Yin-bo-de/wheel_speed_monitor/hardware/README.md

# 转接底板（硬件 v6：正面插装、外设 5V、A3144 脚序）

轮速监测台的转接底板：原理图 + PCB 布局布线，全部脚本生成。Freenove
ESP32-S3 WROOM CAM 开发板**正面朝上**插在底板的两个 20 针排母上（J1 对右排
IO43 列，J2 对左排 3V3 列），霍尔、舵机、遥控、电源的接线全部从底板的端子上走；
开发板全部 40 针另有 1:1 的扩展排针，将来固件用到新脚不用重新打板。板子
**96 × 98.5mm**（v5 把高度从 122 压到 98.5，落进嘉立创 100×100 的打样档；
宽度没动），双层，三个 M2.5 安装孔（v6 取消左下角，给 J12 端子下移让位）。v6 在 v5 基础上改了几件事：开发板改为
正面插装、舵机固定吃板载 5V、霍尔接口脚序改成 A3144 的 +V/GND/OUT；遥控三通道
合并成一个 3 针信号排针，接收机的电源/地仍走 J17；C4 升到 1000µF/16V。

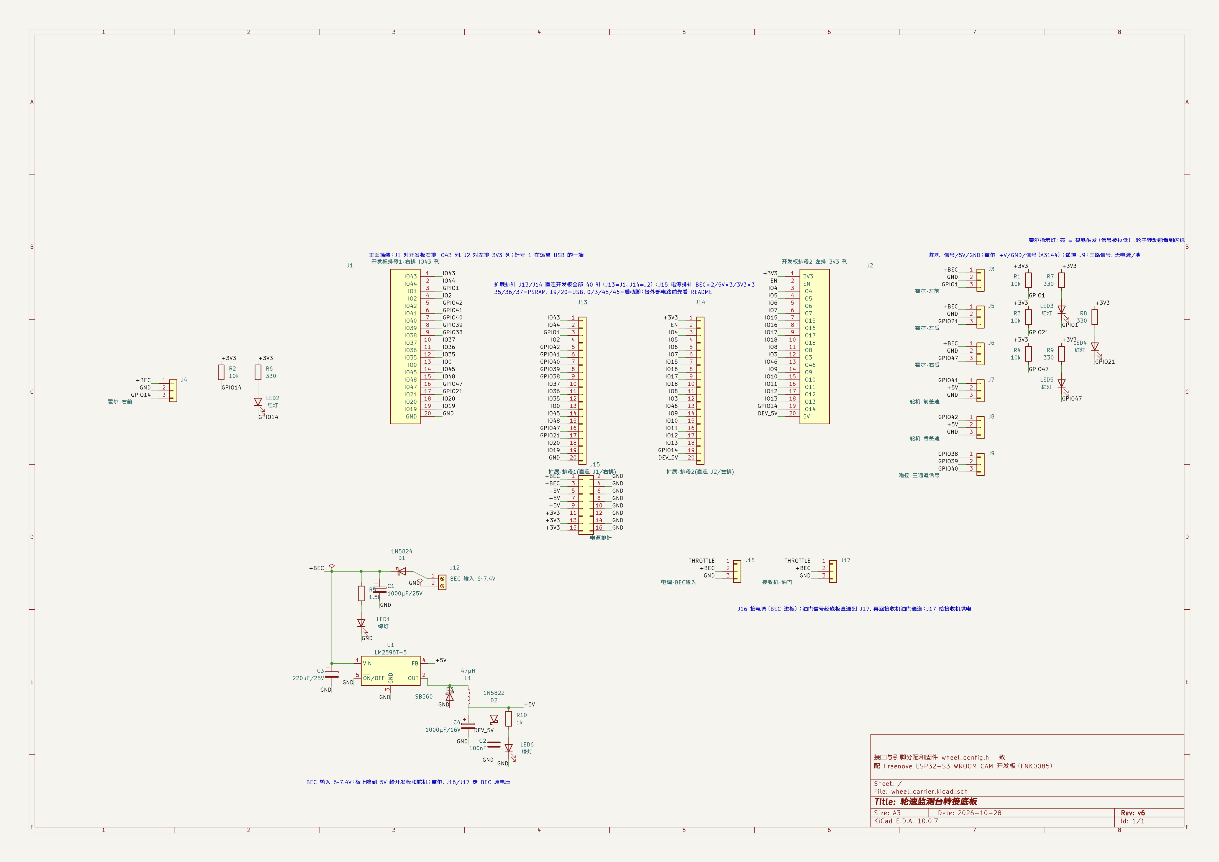
[picture p1: hardware/wheel_carrier/preview.png]
原理图预览


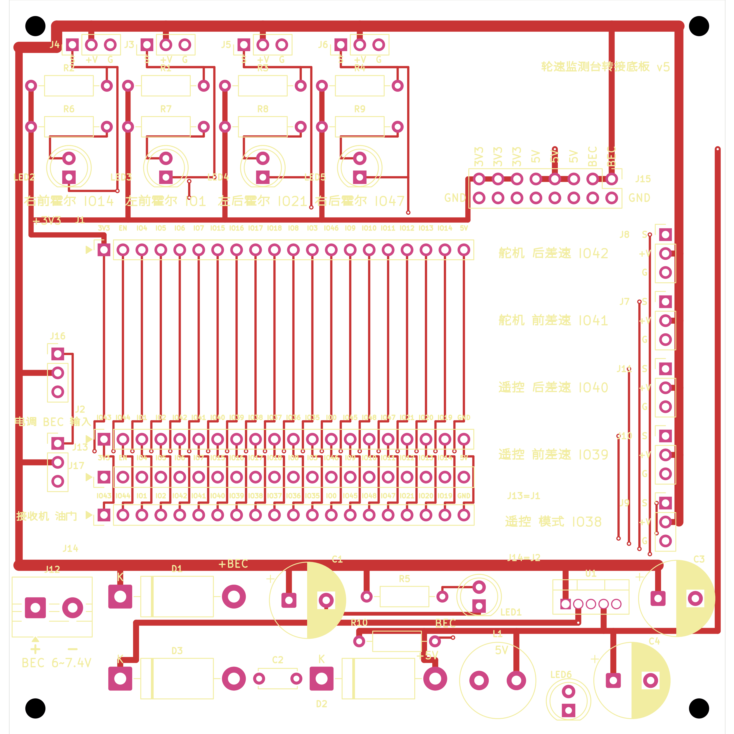
[picture p2: hardware/wheel_carrier/pcb_top.png]
PCB 顶层


- **图纸**：用 KiCad 打开 `wheel_carrier/wheel_carrier.kicad_pro`（双击即可）。
- **生成器**：`scripts/gen_schematic.py`（原理图）+ `scripts/gen_pcb.py`（PCB），
  内容全是脚本里的常量，改完重跑就出新版。
- **验证状态**：原理图 ERC 0/0；PCB DRC **全零**（0 错误、0 警告，含丝印类）；
  Gerber + 钻孔文件已导出（`wheel_carrier/wheel_carrier-gerber.zip`，
  可直接传嘉立创），钻带里含 3 × Ø2.7 安装孔。

## 这块板做什么

| 项目 | 说明 |
|---|---|
| 开发板封装 | 2 个 20 针排母（J1 顶排 = 开发板右排 IO43 列，J2 底排 = 左排 3V3 列），**正面插装** |
| 扩展排针 | **J13/J14 直连开发板全部 40 针（1:1）**；J15 电源条（2×8：BEC×2 / 5V×3 / 3V3×3，其余 8 针全地） |
| 电调 / 油门 | J16 收电调的 3 针插头（BEC 进板）；油门信号经底板直通到 J17 → 接接收机油门通道 |
| 电源输入 | J12 两针螺丝端子进 **BEC 6~7.4V**（电调 BEC 输出） |
| +BEC 主路 | 防反接后分给：J3~J6 霍尔的 +V、J17、J15 的 BEC 针、C1 大电容、降压段 |
| 5V 降压 | LM2596T-5.0 + 47µH 电感 + 续流管 + 输入/输出电容，5V 供开发板和两路舵机 |
| 防倒灌 | D2 串在给开发板的支路上，USB 与底板供电互不倒灌 |
| 霍尔 ×4 | J3 左前 / J4 右前 / J5 左后 / J6 右后，脚序 **+V / GND / 信号**（对 A3144），各配 10k 上拉到 3.3V |
| 霍尔指示 | 每路信号一个 330R + 红灯：**亮 = 磁铁触发**（信号被拉低），转起来能看到闪烁 |
| 舵机 ×2 | J7 前差速 / J8 后差速，+V 固定为板载 **5V** |
| 遥控 | J9 一个 3 针排针：1=模式 / 2=前差速 / 3=后差速，**只走信号**；接收机电源/地走 J17 |
| 大电容 | C1 1000µF/25V 兜输入母线；C4 1000µF/16V 兜 5V 舵机堵转 |
| 指示灯 | LED1 绿灯 = +BEC 已上电；LED6 绿灯 = 降压段有 5V 输出 |

接口脚序不再统一：**舵机 J7/J8 是 信号 / +5V / GND；霍尔 J3~J6 是 +V(BEC) / GND /
信号（A3144 的 1=VCC、2=GND、3=OUT）；遥控 J9 只有三路信号，没有电源和地。**
信号脚的 GPIO 分配与固件 `main/wheel_config.h` 完全一致，软件一行不用改。

### 引脚映射（与固件 wheel_config.h 一致）

| 接口 | 接到开发板排针 | GPIO |
|---|---|---|
| 霍尔·左前 J3 | J1 第 3 针 | 1 |
| 霍尔·右前 J4 | J2 第 19 针 | 14 |
| 霍尔·左后 J5 | J1 第 17 针 | 21 |
| 霍尔·右后 J6 | J1 第 16 针 | 47 |
| 舵机·前差速 J7 | J1 第 6 针 | 41 |
| 舵机·后差速 J8 | J1 第 5 针 | 42 |
| 遥控 J9·1 模式 | J1 第 9 针 | 38 |
| 遥控 J9·2 前差速 | J1 第 8 针 | 39 |
| 遥控 J9·3 后差速 | J1 第 7 针 | 40 |
| 开发板 5V 输入 | J2 第 20 针 | — |
| 开发板 3.3V（上拉与指示取电） | J2 第 1 针 | — |
| 开发板 GND | J1 第 20 针 | — |

排针针号 1 从**远离 USB 口**的一端数起，四个 20 针排针的 1 脚都在最左端
（丝印上有实心三角标），每一针的网名（3V3 / IO4 / IO47…）都印在排针旁边，
装板前对一遍即可。**v6 是正面插装：J1 顶排对应开发板右排（IO43 列），J2 底排
对应左排（3V3 列）**；开发板天线朝左、USB 朝右，和 v5 反面插时的物理朝向一致。
J13/J14 的针号与 J1/J2 一一对应（J13 第 n 针 = J1 第 n 针，J14 = J2），排针右端
另有 J13=J1、J14=J2 标注。

### 扩展排针的用法与红线

将来固件要用新 GPIO（比如二期 IMU 的 I2C），把杜邦线插到 J13/J14 对应针上就行。
引出的脚跟排母是 1:1 并联的，接外设等于并联一支，原功能不受影响。但有几条红线：

| 引脚 | 情况 |
|---|---|
| 35 / 36 / 37 | PSRAM 数据线，接任何外部电路都会把 PSRAM 弄坏（能拿表测，不能接东西） |
| 19 / 20 | 原生 USB 的 D-/D+。用 USB 口烧录/调试时不能接；改走 CH343 口烧录才可复用 |
| 0 / 3 / 45 / 46 | 启动模式脚：上电瞬间被采样，外部电路拉着它们会进不了正常启动 |
| 4–18 | 摄像头位（IO4/IO5 是 I2C）。要复用先拔摄像头排线 |
| 43 / 44 | 板载 CH343 串口，占着烧录通道，别动 |

### 电源条（J15）与电调口（J16/J17）

- **J15 是 2×8 电源条**：上排 8 针是电源（西→东：3V3、3V3、3V3、5V、5V、5V、BEC、BEC），
  下排 8 针全是对应的 GND——每一列「电源 + 地」相邻，两针的杜邦壳插一列就能给传感器
  供电，GND 管够（每个传感器、每根探针都要一根地）。
- **J16 收电调的 3 针插头**：BEC 电压从这里进板（三针插头中间那根必是 +V，
  插反只会信号线和地线换位，电源接不反），油门信号也从这里进板。
- **J17 去接收机**：用三针杜邦线接到接收机的油门通道。板载直通走线把 J16/J17 的
  信号针连通——油门信号「过板」，但那根直通是纯铜走线，**板子不通电也照传信号**，
  主控不在线不会断油门；J17 的 +V 是接收机唯一的电源入口（v6 的 J9 只走信号，
  不再给接收机供电）。
- **遥控 J9**：一个 3 针信号排针，1=模式、2=前差速、3=后差速；接收机的电源和地
  仍从 J17 取，接线时 J17 必须插上，否则三路信号没有参考地。
- 进电方式二选一（或都用）：J12 螺丝端子（粗线 / 大电流）或 J16（即插即用）。
  **同一时间只允许一个电源来源**——别把两路不同电源同时接进这两种入口。

## 设计决定的理由

**电源条为什么是 2×8、每列配一根地。** 一根 2.54 针只插得下一根杜邦线——原版
4 针的电源口挂两个传感器就不够分。传感器真正费的是针位（每台都要电源+地两根），
所以 v4 把电源口扩成 2×8：8 路电源、8 根地按列配对。信号类的预留继续走 J13/J14
扩展排针——不给每个设想都做专用口，真到接线烦了再加。

**电调口（J16/J17）为什么让油门过板。** 电调的三针插头直接插板子，BEC 从口上进
（与 J12 同一个节点，粗线大电流仍旧可以走端子）；油门信号用板上直通走线送到 J17
再回接收机。代价是油门路径多了两个插头，换来的是接线只有两根（电调到板、板到
接收机），而且以后固件想读油门（油门 + 四轮速算滑移率）信号点就在板上，加一根
跳线到空闲 GPIO 即可。v6 把 J9 收成纯信号排针后，J17 还是接收机唯一的电源/地
入口——这一口既送油门信号，也送 BEC 和地。

**为什么把 40 针全部引出来。** 固件还在长（二期有 IMU），下一个功能用哪根脚
说不准；把没在用的脚也引到扩展排针，将来插线即用、不用重新打板。这也是为什么
画在布局之前——原理图阶段加两排针几乎零成本。2.54 杜邦级够接传感器/模块；
真到要大功率或专用连接器的扩展（电机驱动之类），那还是得动板子。

**BEC 的 6/7.4V 不能直接进开发板，也不能直接进舵机。** 开发板 5V 脚是按 5V
设计的，7.4V 灌进去会烧板上的 5V 器件、还会倒灌 USB；普通舵机也只到 6V 左右。
所以板上用 **LM2596T-5.0** 做了一路真降压：TO-220 直插好焊、嘉立创几块钱，配
47µH 电感、续流管、输入（C3 220µF/25V）输出（C4 1000µF/16V）电容，就是这款
芯片的教科书接法。v6 把两路舵机也挂到这路 5V 上，C4 因此从 220µF 加到 1000µF，
堵转时电压更稳。

**舵机吃 5V，接收机吃 J17 的 BEC，霍尔吃 BEC。** 舵机固定 5V 是为了不挑 BEC
档位：6V、7.4V 甚至 4S 直接进板，舵机看到的都是 5V。接收机仍走 J17 的 +BEC，
所以 4S 直接进板时 J17 的 +V 是 16.8V，接收机的 +V 线必须手动空出来（由电调
BEC 单独供电）；J9 只走三路信号，没有电源脚，不受影响。霍尔 A3144 标称
4.5~24V，16.8V 也在范围内，可以继续从 J3~J6 的 +V 取电。

**6V 档时 5V 段会略低于 5.0V，属正常。** BEC 6V 经防反接二极管掉到约 5.6V，
LM2596 在这个压差下接近直通、输出大约 4.9~5.1V。这没有关系：开发板的 3.3V
稳压器输入 4.5V 以上就正常工作，舵机在 4.9V 也能用。7.4V 档时稳压在 5.0V。

**霍尔供电走 BEC、信号上拉走 3.3V。** 之前 3.3V 供电的隐患（A3144 规格下限
4.5V）彻底解决；上拉电压 3.3V 决定 GPIO 高电平，开集电极输出对 ESP32 安全。

**霍尔指示灯的接法与门道。** 每路信号从 3.3V 经 330R 串一个 LED 到信号脚：
信号被传感器拉低（磁铁靠近）时电流导通、灯亮；信号为高时 LED 两端等电位、自动
熄灭。电流约 4mA，在 A3144 的 20mA 灌电流能力之内，也不会把信号拉到读不出低电平。
用 3.3V 而不是 BEC 是刻意的：LED 只借用信号线当"回路"，不往信号里引入 BEC 电压。

**开发板供电串了第二只肖特基 D2。** 插着 USB 调程序时，5V 段和 USB 5V 会在开发
板上顶牛（互相倒灌）。串上之后两边都能单独供电，谁先谁后都无所谓。

**电源网络用标签、不摆电源符号。** 电源符号和同名标签混用会触发 ERC 的
same_local_global_label 警告（本来就是同一张网），统一用标签表达。PWR_FLAG 是
例外——它不改网络名，只负责让 ERC 认可 +BEC/GND 母线有驱动源（降压芯片的
VIN/GND 是 power_in 引脚，没旗标 ERC 会点名）。

## PCB 设计要点

**布局**（`gen_pcb.py` 的 PLACEMENT 表，坐标为焊盘包围盒中心）：
顶部一排是霍尔接口 + 10k 上拉 + 330R/指示灯三行；中部的两个 20 针排母把开发板
架空；右侧只剩 J8 后差速舵机、J7 前差速舵机、J9 遥控三通道三个三针口，自上而下
排列；扩展排针 J13/J14 放在排母正下方，40 根 1:1 竖线呈「线帘」状；电源区在底部。

**布线**（TRACKS 表，直角折线 + 过孔换层）：
- 正面 F.Cu 走信号 + 电源：+BEC 从左脊上到顶、给四个霍尔 +V 和电源条 BEC 列；
  +5V 的舵机支路加粗到 1.2~1.5（J8/J7 堵转电流），+3V3 0.5~0.8，信号 0.3；
  开发板 40 针到扩展排针的竖线利用排母行列间的 1.27mm 间隙；v5 把 J13/J14
  收到 J2 下方 5.08mm 后，扇形引出改成"半间距错位车道"——J1 列的线走 x−1.27、
  J2 列走 x+1.27（两组按时段借用同一条物理车道），每列一个过孔从 B 层直接
  扎进 J13。
- 背面 B.Cu 是整板 GND 铺铜 + 少量跨板长走线（四条霍尔信号、两条舵机 + 三条
  遥控信号、DEV_5V 东缘通道）；v6 把 GPIO14 的横巷放到 J1 北侧、从左侧半间距
  车道下到 J2.19，其余三路霍尔和五路右侧信号在 J1 北/南两侧的 B 层横巷里
  分开走。GND 焊盘靠铺铜的热焊盘自动连通，被走线围死的少数几处改成实心连接。
  被净空围死、又接不到任何焊盘的铺铜碎块会被 KiCad 当孤岛自动删掉（漂浮铜
  不如不要）；而"某片地铜与主铺铜不通"（DRC 报「未连接项目」）优先查**铺铜的
  `min_thickness`**：KiCad 默认 0.254 填不进密集区的窄缝，会把整张地网分裂成
  好几片互相不通的铜块——调到 0.2 后自动合体，比一根根补缝合线本质得多。
  这块板上最明显的例子是 LED3 附近：GPIO1 的 B 层横巷（北/西）和 GPIO14 的
  B 层横巷（南/东）围出一个口袋，口袋里没有 GND 焊盘，铺铜进不去也接不到地，
  KiCad 就把这块孤立铜删掉了——会看到一块空白，这是正常结果，不是漏铺。
- 每个过孔、每段净空都是对着 DRC 报告逐条磨出来的；`gen_pcb.py` 里那些
  「x=... y=...」的注释坐标不是随意摆的，改动前先跑 DRC。

**丝印标注**（`build_silk()`：132 条文字 + 4 个 1 脚三角标，坐标表就在函数里）：

- 九个接口旁印**功能名 + GPIO 号**（如「左后霍尔 IO21」「舵机 前差速 IO41」），
  霍尔标 +V / G / S（对 A3144），舵机标 S / +V / G，遥控 J9 标「模 / 前 / 后」，
  插线不用查图纸；
- J1/J2 与 J13/J14 **每一针的网名**（3V3 / IO4 / IO47…）错行排在排针旁，
  开发板插装、将来插杜邦线都靠它；J1/J2 旁边另印「正面插入 USB→」；
- J15 电源条每个电源脚把自己的电压竖标在所在列的正上方（3V3×3 / 5V×3 / BEC×2），
  下排两端各标一个 GND——一眼读出「上排电源、下排地、每列一对」；
  J16/J17 印功能名（「电调 BEC 输入」「接收机 油门」）；J12 端子下方有 +/- 极性
  和「BEC 6~7.4V」；三条电源母线标了 +BEC / +3V3 / +5V，两个绿灯标了用途；
  右上角是板名与版本。
- 网名不手写——`io_name()` 从网表取，原理图改了 GPIO 分配，构建会直接报错
  而不是印出过期的号；写完先过 `check_silk()` 的几何自检（逐条文字对 182 个
  焊盘开窗、板边、其他文字做包围盒检查），再过 KiCad DRC 复核。

**DRC 与导出的正确姿势**（顺序敏感）：

```bash
CLI=/Applications/KiCad/KiCad.app/Contents/MacOS/kicad-cli
python3 scripts/gen_pcb.py                        # 重新生成（未填铺铜）
"$CLI" pcb drc --refill-zones --save-board \
    --output /tmp/pcb_drc.rpt wheel_carrier/wheel_carrier.kicad_pcb   # 重填铺铜+存回
"$CLI" pcb export gerbers --output wheel_carrier/gerber/ wheel_carrier/wheel_carrier.kicad_pcb
"$CLI" pcb export drill --output wheel_carrier/gerber/ --format excellon \
    --excellon-units mm wheel_carrier/wheel_carrier.kicad_pcb
```

坑：`pcb drc` 不带 `--refill-zones` 时**不填铺铜**，GND 会报几十条假「未连接」；
带上 `--save-board` 才会把铺铜写回文件（gerber 也才有铜皮）。生成器重跑会清掉
铺铜，导出前记得再走一遍这个流程。

另一个坑：kicad-cli 的部分操作（导出/DRC）会把 `.kicad_pro` 重写成完整版，
顺手把 `lib_footprint_mismatch` 的降级忽略丢掉（二十来条警告复活）。
`gen_pcb.py` 每次运行会自动把这条设置补回（自愈），别手工去跟它较劲。

**已知接受项**（都是丝印/外观级，不影响打样与功能）：
- 全项清零：丝印类（位号挪位 + 文字几何自检）与连接类（见下）都已修复，
  DRC 现在是 0 错误 0 警告；
- 此前那条 `unconnected`（LED1 / 中区地铜与外围断开）的根因找到了：**铺铜的
  `min_thickness` 默认 0.254 在密集区填不进窄缝**，把整张地网悄悄分裂成两片；
  调到 0.2（≥ 设计规则下限 0.2）后整片连通——参数在 `gen_pcb.py` 的铺铜段，
  别改回 0.254；
- `lib_footprint_mismatch` 已在 `.kicad_pro` 里降级忽略（我们有意改了位号
  字号和部分焊盘）；U1 的库盘 1.275×1.8 配 1.1 孔、窄边环宽只剩 0.0875
  （低于板厂常规下限 0.13），按 1.4 等比放大（环 0.15），间距和孔径照库不动。
- 安装孔曾经是"隐形"的：`mounting_hole()` 抄库封装时把 pad 节点跳过了，而
  2.7mm 钻孔就挂在 pad 上——钻带里一把 2.7 的刀都没有，铜还直接压在孔位上
  （左上角 +BEC 主干线从孔心穿过）。修复：保留 pad 节点 + 顶干线第一跨绕孔
  （y=6.35 一跨，孔边铜距 0.75），`check_silk()` 也把四个孔的开窗纳入自检。
  教训：KiCad DRC 只认板文件里真实存在的东西，孔没进文件时它不会替你把关。
- v5 压缩到 96 × 98.5 之后，四条 20 针排针的行距只剩 5.08mm：排针脚名标注从
  两行 0.8 号字改成单行 **0.58 号**，`.kicad_pro` 的文字高度下限跟着放到 0.55
  （生成器每次运行自愈，和 `lib_footprint_mismatch` 一样）。丝印密集区的现实
  折中，板厂工艺无压力（看得清要凑近点）。
- v4 那根「救铺铜孤岛」的 GND 缝合线（J1 上方带子）在 v5 里删了：布局收紧后
  那段空档已经小到铺铜自己会忽略，留着反而是一根悬空端（DRC 会点名）。

## BOM（40 个元件，全部直插，方便手焊）

| 位号 | 元件 | 封装 |
|---|---|---|
| J1, J2 | 1×20 排母 | PinSocket_1x20_P2.54mm_Vertical |
| J13, J14 | 1×20 排针（扩展） | PinHeader_1x20_P2.54mm_Vertical |
| J15 | 2×8 排针（电源条） | PinHeader_2x08_P2.54mm_Vertical |
| J3–J9, J16, J17 | 1×3 排针 ×9 | PinHeader_1x03_P2.54mm_Vertical |
| J12 | 2 位 5.0mm 螺丝端子 | MX126-5.0-02P（或同类 bornier） |
| U1 | LM2596T-5.0（固定 5V 降压） | TO-220-5_Vertical |
| L1 | 47µH 直插电感 | L_Radial_D10.0mm（Fastron 07P 或同类） |
| D1 | 1N5824 肖特基（5A，整板总电流含 5V 舵机支路） | D_DO-201AD |
| D2, D3 | D2：1N5822（3A）；D3：SB560（5A/60V，续流管） | D_DO-201AD |
| C1 | 1000µF/25V 电解 | CP_Radial_D10.0mm_P5.00mm |
| C3 | 220µF/25V 电解 | CP_Radial_D10.0mm_P5.00mm |
| C4 | 1000µF/16V 电解（v6 从 220µF 升级） | CP_Radial_D10.0mm_P5.00mm |
| C2 | 100nF 瓷片 | C_Disc_D5.0mm |
| R1–R4 | 10k（霍尔上拉） | R_Axial_DIN0207（P10.16mm） |
| R5, R10 | 1.5k / 1k（电源指示限流；R5 为 BEC、R10 为 5V） | 同上 |
| R6–R9 | 330R（霍尔指示限流） | 同上 |
| LED1, LED6 | 5mm 绿色（BEC / 5V 指示） | LED_D5.0mm |
| LED2–LED5 | 5mm 红色（霍尔指示） | LED_D5.0mm |

> v6 删掉了 J10/J11，遥控三通道并成 J9 一个 3 针信号排针；C4 升到 1000µF/16V。
> C1/R5/D3 已按 4S 输入升级（C1 25V、R5 1.5k、D3 SB560）。4S 接法与注意事项见
> [使用说明书](使用说明书.md)。

## 改图纸的姿势

两条路，选一条：

1. **改常量重跑**（推荐，图纸进 git、每版可复现）：
   ```bash
   python3 scripts/gen_schematic.py          # 原理图：.kicad_sch / .kicad_sym / 工程文件
   python3 scripts/gen_pcb.py                # PCB：.kicad_pcb（导 gerber 前记得重填铺铜，见上）
   python3 scripts/reload_kicad.py           # 让 KiCad 里打开着的图纸立刻刷新（见下）
   ```
   布局常量、网络、元件表都在脚本顶部一节一节排好。
   刷新脚本走 KiCad 的 IPC API（「设置 → 插件」里启用后重启一次 KiCad 生效），
   等价于菜单 File → Revert：PCB 能直接刷新；原理图侧 KiCad 10 的 API 还没实现，
   得在 eeschema 里手动按 File → Revert（一步，也不用关软件）。Revert 会丢弃
   界面上未保存的手工改动，和菜单行为一致。
2. **直接在 KiCad 里改**：改完必须同步回脚本，否则下次重跑会被覆盖。同步走
   `kicad-sync` 技能（对话里输 `/kicad-sync`；工具在
   `~/.claude/skills/kicad-sync/scripts/`，是仓外的东西，换机器要带走）：
   `board_diff.py --vs-generated` 语义对比找出改动（KiCad 每次保存都会重排
   格式，逐字节 diff 读不了）→ 改动翻译进脚本 → `rebuild.py` 重跑生成器、
   闭环核对（差异必须归零）、重出全部产物。

自检三件套（改完跑一遍）：

```bash
CLI=/Applications/KiCad/KiCad.app/Contents/MacOS/kicad-cli
"$CLI" sch erc --severity-all --output /tmp/erc.rpt wheel_carrier/wheel_carrier.kicad_sch
"$CLI" sch export netlist --format kicadsexpr --output /tmp/wheel.net wheel_carrier/wheel_carrier.kicad_sch
"$CLI" sch export pdf --output /tmp/sch.pdf wheel_carrier/wheel_carrier.kicad_sch
# PDF 转图目检：sips -s format png -Z 4400 /tmp/sch.pdf --out /tmp/sch.png
```

几条给后来人的提醒（全是实际踩过的坑）：

- 旋转 90° 摆放的器件，属性文字要写 90° 角度（相对符号）才会横排；而且 KiCad
  会把 180° 的文字翻正显示、同时反转左右对齐——旋转件文字用「居中」定位最省心。
- 密集区里，相邻器件的伸线端点如果落在同一坐标，两条网络会被静默短接（ERC 都
  不一定报）。上拉电阻那排就是这么撞过一回，改成了标签直贴引脚端点。生成器里的
  `g()` 会断言所有坐标在 1.27 网格上，但「同坐标」这类问题还是要靠网表核对。
- KiCad 官方库里不少器件是 `extends` 派生写法（比如 LM2596T-5 继承 LM2596T-12
  的图形）。`kicad_lib.resolve_symbol()` 会自动把父符号的图形/引脚并进来，直接
  用 `find_symbol` 会拿到没有引脚的空壳。
- **PCB 封装的原点在 1 号焊盘上，不是器件中心**：直接按「中心」摆位整体会偏
  半个身位——配好的脚位全错过、外框互相压（实测一次撞出 20 多处）。`gen_pcb.py`
  的 PLACEMENT 表坐标语义是「焊盘包围盒中心」，由脚本解析封装尺寸自动换算；
  手工加件、手改坐标时记住这个语义。
- **同网络的走线允许自然汇合**：走线冲突不一定要绕开，经常可以「把两段的同网
  成员接在一起」（比如霍尔信号直接汇进它在扩展排针的绕行竖线上）。这块板靠
  这一手把四条霍尔网和五条遥控/舵机网从「单层必打结」里救了出来；而冲突点
  不用肉眼找，DRC 报告会给精确到 0.01mm 的坐标。
- **丝印文字压到焊盘开窗会被阻焊裁掉**（字缺一块，不可接受）、压到器件自带
  丝印框只是外观告警。所以 `gen_pcb.py` 内置 `check_silk()`：每条文字对全部
  焊盘开窗、板边、其他文字做包围盒检查，不通过直接构建失败——比生成后再看
  DRC 报告改得快。注意校验用的是保守字宽（CJK 按 1.15 倍字号估），改字号后
  留的空档别贴着估出来的边。
- **旋转 270° 的器件改位号位置时，局部坐标的 x 在屏幕上是 y 方向**：R10 挪
  位号时改错了分量，字往下方跑了一格。`REF_MOVES` 表里的坐标都是各封装自己
  的局部系，改之前先把 `rot_off()` 的换算方向默写一遍。
- **位号默认位置是封装库给的**，好几个默认就压邻件（LED1/LED6 的位号压在
  R5/R10 焊盘上会被阻焊裁断、C4 的位号压在 C3 的丝印圆上）。这类问题不用等
  DRC：`check_silk()` 会把位号也当文字检查（`ref_local()` 保证自检读到的位置
  就是文件里写的位置），`REF_MOVES` 表收集所有需要挪的位号。

## 本版明确没做的事

- 保险丝、霍尔信号滤波电容（当前用不上，避免多焊点）
- 打样下单与回板焊接（下一步；gerber 已就绪）
- 传感器/接收机侧的线束加工（沿用现有线材即可）
- 舵机没有独立 5V BEC：两路舵机和开发板共用板上 LM2596，3A 是芯片上限；
  换大舵机时要么另配 5V BEC，要么重新评估这一路
- 接收机电源/地只走 J17，J9 不单独供电；接线时 J17 必须插上，否则三路信号
  没有参考地
- 转向通道输入口、I2C（MPU6050）专用口：从 J13/J14 扩展排针拉杜邦就能用
  （任何空闲 GPIO 都在上面），真到接线嫌烦时再加一轮
