Yin-bo-de/wheel_speed_monitor/hardware/wheel_carrier/pcb_bot.png

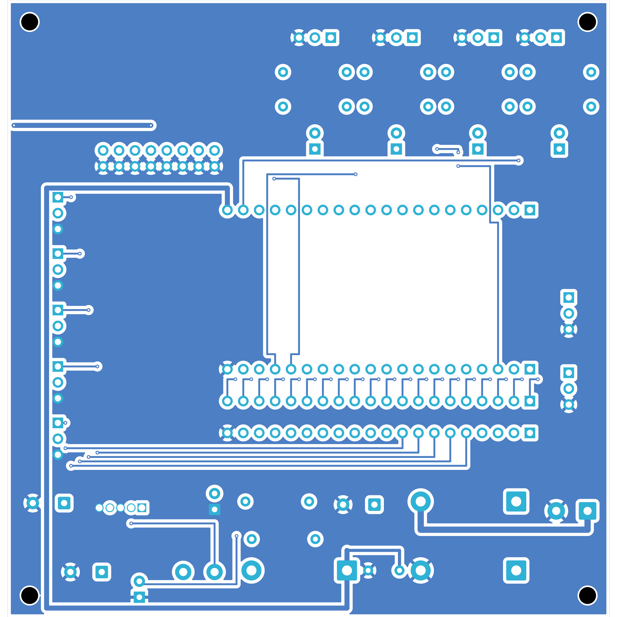
hardware/wheel_carrier/pcb_bot.png
