Yin-bo-de/wheel_speed_monitor/hardware/wheel_carrier/wheel_carrier.kicad_pcb

## KiCad design hardware/wheel_carrier/wheel_carrier.kicad_pcb (2026-10-30)

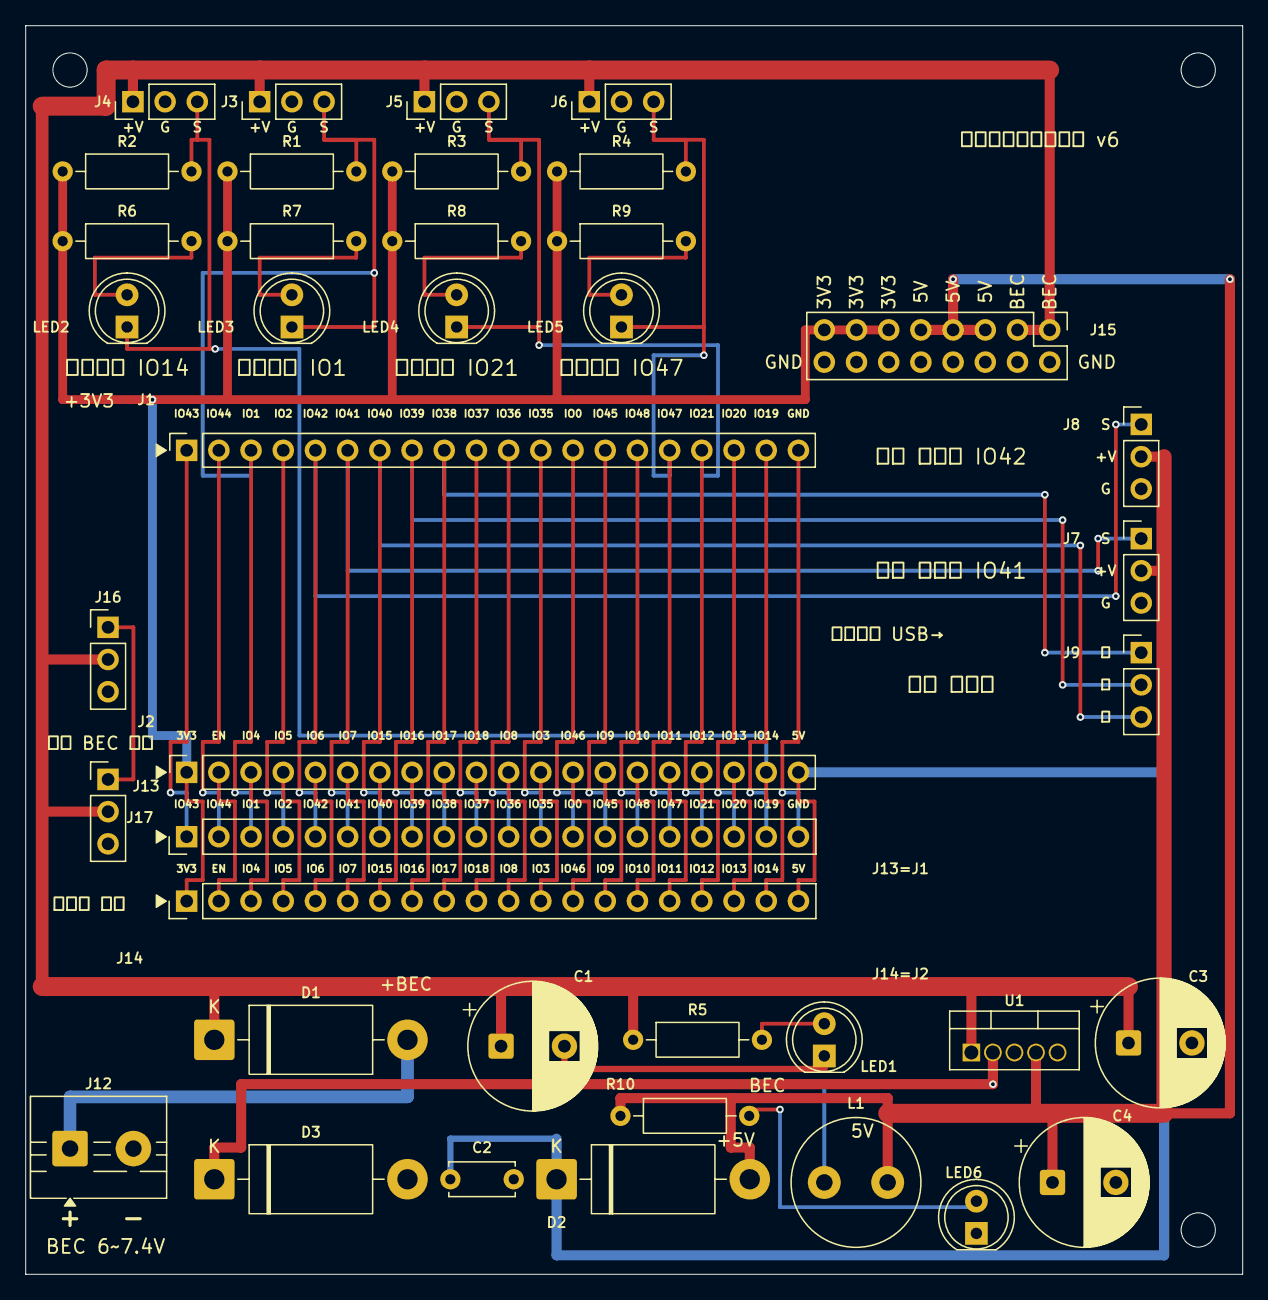
[picture p4: board wheel_carrier.kicad_pcb from above]

Board: 2 copper layers, 96.0 x 98.5 mm, 40 parts (0 on the bottom side), 51 nets.

Parts:
C1: 1000µF/25V; CP_Radial_D10.0mm_P5.00mm
C2: 100nF; C_Disc_D5.0mm_W2.5mm_P5.00mm
C3: 220µF/25V; CP_Radial_D10.0mm_P5.00mm
C4: 1000µF/16V; CP_Radial_D10.0mm_P5.00mm
D1: 1N5824; D_DO-201AD_P15.24mm_Horizontal
D2: 1N5822; D_DO-201AD_P15.24mm_Horizontal
D3: SB560; D_DO-201AD_P15.24mm_Horizontal
J1: 开发板排母1·右排(IO43列); PinSocket_1x20_P2.54mm_Vertical
J2: 开发板排母2·左排(3V3列); PinSocket_1x20_P2.54mm_Vertical
J3: 霍尔·左前; PinHeader_1x03_P2.54mm_Vertical
J4: 霍尔·右前; PinHeader_1x03_P2.54mm_Vertical
J5: 霍尔·左后; PinHeader_1x03_P2.54mm_Vertical
J6: 霍尔·右后; PinHeader_1x03_P2.54mm_Vertical
J7: 舵机·前差速; PinHeader_1x03_P2.54mm_Vertical
J8: 舵机·后差速; PinHeader_1x03_P2.54mm_Vertical
J9: 遥控·三通道信号; PinHeader_1x03_P2.54mm_Vertical
J12: BEC 输入 6~7.4V; TerminalBlock_MaiXu_MX126-5.0-02P_1x02_P5.00mm
J13: 扩展·排母1(直连 J1/右排); PinHeader_1x20_P2.54mm_Vertical
J14: 扩展·排母2(直连 J2/左排); PinHeader_1x20_P2.54mm_Vertical
J15: 电源排针; PinHeader_2x08_P2.54mm_Vertical
J16: 电调·BEC输入; PinHeader_1x03_P2.54mm_Vertical
J17: 接收机·油门; PinHeader_1x03_P2.54mm_Vertical
L1: 47µH; L_Radial_D10.0mm_P5.00mm_Fastron_07P
LED1, LED6: 绿灯; LED_D5.0mm
LED2, LED3, LED4, LED5: 红灯; LED_D5.0mm
R1, R2, R3, R4: 10k; R_Axial_DIN0207_L6.3mm_D2.5mm_P10.16mm_Horizontal
R5: 1.5k; R_Axial_DIN0207_L6.3mm_D2.5mm_P10.16mm_Horizontal
R6, R7, R8, R9: 330; R_Axial_DIN0207_L6.3mm_D2.5mm_P10.16mm_Horizontal
R10: 1k; R_Axial_DIN0207_L6.3mm_D2.5mm_P10.16mm_Horizontal
U1: LM2596T-5; TO-220-5_Vertical

Connections:
+3V3: J2.1, J14.1, J15.11, J15.13, J15.15, R1.1, R2.1, R3.1, R4.1, R6.1, R7.1, R8.1, R9.1
+5V: C4.1, D2.2, J7.2, J8.2, J15.5, J15.7, J15.9, L1.2, R10.1, U1.4
+BEC: C1.1, C3.1, D1.1, J3.1, J4.1, J5.1, J6.1, J15.1, J15.3, J16.2, J17.2, R5.1, U1.1
DEV_5V: C2.1, D2.1, J2.20, J14.20
EN: J2.2, J14.2
GND: C1.2, C2.2, C3.2, C4.2, D3.2, J1.20, J3.2, J4.2, J5.2, J6.2, J7.3, J8.3, J12.2, J13.20, J15.2, J15.4, J15.6, J15.8, J15.10, J15.12, J15.14, J15.16, J16.3, J17.3, LED1.1, LED6.1, U1.3, U1.5
GPIO1: J1.3, J3.3, J13.3, LED3.1, R1.2
GPIO14: J2.19, J4.3, J14.19, LED2.1, R2.2
GPIO21: J1.17, J5.3, J13.17, LED4.1, R3.2
GPIO38: J1.9, J9.1, J13.9
GPIO39: J1.8, J9.2, J13.8
GPIO40: J1.7, J9.3, J13.7
GPIO41: J1.6, J7.1, J13.6
GPIO42: J1.5, J8.1, J13.5
GPIO47: J1.16, J6.3, J13.16, LED5.1, R4.2
IO0: J1.13, J13.13
IO2: J1.4, J13.4
IO3: J2.12, J14.12
IO4: J2.3, J14.3
IO5: J2.4, J14.4
IO6: J2.5, J14.5
IO7: J2.6, J14.6
IO8: J2.11, J14.11
IO9: J2.14, J14.14
IO10: J2.15, J14.15
IO11: J2.16, J14.16
IO12: J2.17, J14.17
IO13: J2.18, J14.18
IO15: J2.7, J14.7
IO16: J2.8, J14.8
IO17: J2.9, J14.9
IO18: J2.10, J14.10
IO19: J1.19, J13.19
IO20: J1.18, J13.18
IO35: J1.12, J13.12
IO36: J1.11, J13.11
IO37: J1.10, J13.10
IO43: J1.1, J13.1
IO44: J1.2, J13.2
IO45: J1.14, J13.14
IO46: J2.13, J14.13
IO48: J1.15, J13.15
unnamed: D1.2, J12.1
unnamed: D3.1, L1.1, U1.2
unnamed: LED1.2, R5.2
unnamed: LED2.2, R6.2
unnamed: LED3.2, R7.2
unnamed: LED4.2, R8.2
unnamed: LED5.2, R9.2
unnamed: LED6.2, R10.2
THROTTLE: J16.1, J17.1
