Yin-bo-de/wheel_speed_monitor/main/config_params.c

/* config_params 实现：见头文件注释。 */
#include <string.h>

#include "config_params.h"

void cfg_params_default(cfg_params_t *cfg)
{
    memset(cfg, 0, sizeof(*cfg));
    cfg->magnets = 1;
    cfg->wheel_diam_mm = 105;
    cfg->alpha = 0.3f;
    for (int i = 0; i < CFG_WHEEL_COUNT; i++) {
        cfg->wheel_enabled[i] = true;
    }
    cfg->sim_on = false;
    cfg->debounce_ms = 0;

    cfg->servo_sim = true;
    for (int i = 0; i < CFG_SERVO_COUNT; i++) {
        cfg->servo_en[i] = true;
        /* 两档默认取标准角度舵机的对称两端附近：解锁在中位、锁定偏一端。
         * 前后轴给同一组值——谁装反了谁把这两档改到行程另一端，不要替用户猜。 */
        cfg->servo_unlock_us[i] = 1500;
        cfg->servo_lock_us[i] = 2000;
        cfg->servo_manual_us[i] = 1500;
    }
    cfg->servo_mode = CFG_SERVO_MODE_AUTO;

    cfg->slip_engage_ratio = 0.30f;
    cfg->slip_min_rpm = 10.0f;
    /* 3 秒持续确认：单拍毛刺不触发机械锁，满 3 秒才认为真打滑 */
    cfg->slip_confirm_ms = 3000;
    cfg->lock_hold_ms = 3000;
    cfg->lock_hold_max_ms = 30000;
    cfg->probe_window_ms = 2000;
    cfg->servo_sim_speed_us_s = 3000;

    cfg->rc_sim = false;
    /* 模式通道给 1000（自动区）：打开遥控模拟时不该平白把差速锁从自动改成手动，
     * 想让遥控接管就自己把滑杆推过 1500 */
    cfg->rc_sim_us[0] = 1000;
    cfg->rc_sim_us[1] = 1500;
    cfg->rc_sim_us[2] = 1500;

    /* 摄像头默认按需启动：手机连上热点、打开设置页都不采集。验证台一行
     * 预览请求就够启动，保留 always 给调试常开用。 */
    cfg->cam_policy = CFG_CAM_POLICY_ON_DEMAND;
    cfg->cam_res = CFG_CAM_RES_QVGA;
    cfg->cam_quality = 12;
    cfg->cam_fps_cap = 15; /* 采集和发送共用；网络差时服务端会临时下调 */
    cfg->overlay_mask = CFG_CAM_OVERLAY_ALL;
}

/* 脉宽数组（两档与手动目标同量程）：逐元素判边界，前后轴互不牵连——
 * 前轴填错不该让后轴那组正确值一起被拒。刻意不要求 unlock != lock：
 * 两档相同只是让该轴锁定时不动，调试 PWM 链路时正是想要的效果。 */
static bool servo_us_pair_ok(const uint32_t us[CFG_SERVO_COUNT])
{
    for (int i = 0; i < CFG_SERVO_COUNT; i++) {
        if (us[i] < CFG_SERVO_US_MIN || us[i] > CFG_SERVO_US_MAX) {
            return false;
        }
    }
    return true;
}

esp_err_t cfg_params_validate(const cfg_params_t *cfg, const char *field)
{
    if (cfg == NULL || field == NULL) {
        return ESP_ERR_INVALID_ARG;
    }

    if (strcmp(field, "magnets") == 0) {
        if (cfg->magnets < CFG_MAGNETS_MIN || cfg->magnets > CFG_MAGNETS_MAX) {
            return ESP_ERR_INVALID_ARG;
        }
    } else if (strcmp(field, "diam") == 0 || strcmp(field, "diam_mm") == 0) {
        if (cfg->wheel_diam_mm < CFG_DIAM_MM_MIN || cfg->wheel_diam_mm > CFG_DIAM_MM_MAX) {
            return ESP_ERR_INVALID_ARG;
        }
    } else if (strcmp(field, "alpha") == 0) {
        if (cfg->alpha < CFG_ALPHA_MIN || cfg->alpha > CFG_ALPHA_MAX) {
            return ESP_ERR_INVALID_ARG;
        }
    } else if (strcmp(field, "debounce") == 0 || strcmp(field, "debounce_ms") == 0) {
        if (cfg->debounce_ms > 1000) {
            return ESP_ERR_INVALID_ARG; /* 上限 1s（窗口周期 50ms，去抖带宽合理） */
        }
    } else if (strcmp(field, "servo_unlock_us") == 0) {
        if (!servo_us_pair_ok(cfg->servo_unlock_us)) {
            return ESP_ERR_INVALID_ARG;
        }
    } else if (strcmp(field, "servo_lock_us") == 0) {
        if (!servo_us_pair_ok(cfg->servo_lock_us)) {
            return ESP_ERR_INVALID_ARG;
        }
    } else if (strcmp(field, "servo_manual_us") == 0) {
        if (!servo_us_pair_ok(cfg->servo_manual_us)) {
            return ESP_ERR_INVALID_ARG;
        }
    } else if (strcmp(field, "servo_mode") == 0) {
        if (cfg->servo_mode > CFG_SERVO_MODE_AUTO) {
            return ESP_ERR_INVALID_ARG;
        }
    } else if (strcmp(field, "slip_engage_ratio") == 0) {
        if (cfg->slip_engage_ratio < CFG_SLIP_ENGAGE_MIN || cfg->slip_engage_ratio > 1.0f) {
            return ESP_ERR_INVALID_ARG;
        }
    } else if (strcmp(field, "slip_min_rpm") == 0) {
        if (cfg->slip_min_rpm < 0.0f || cfg->slip_min_rpm > CFG_SLIP_MIN_RPM_MAX) {
            return ESP_ERR_INVALID_ARG;
        }
    } else if (strcmp(field, "lock_hold_ms") == 0) {
        if (cfg->lock_hold_ms < CFG_LOCK_HOLD_MIN_MS ||
            cfg->lock_hold_ms > CFG_LOCK_HOLD_MAX_MS) {
            return ESP_ERR_INVALID_ARG;
        }
    } else if (strcmp(field, "lock_hold_max_ms") == 0) {
        if (cfg->lock_hold_max_ms < CFG_LOCK_HOLD_MIN_MS ||
            cfg->lock_hold_max_ms > CFG_LOCK_HOLD_MAX_MS ||
            cfg->lock_hold_max_ms < cfg->lock_hold_ms) {
            return ESP_ERR_INVALID_ARG; /* 上限低于初始 → 翻倍退避失去意义 */
        }
    } else if (strcmp(field, "probe_window_ms") == 0) {
        if (cfg->probe_window_ms < CFG_PROBE_WINDOW_MIN_MS ||
            cfg->probe_window_ms > CFG_PROBE_WINDOW_MAX_MS) {
            return ESP_ERR_INVALID_ARG;
        }
    } else if (strcmp(field, "slip_confirm_ms") == 0) {
        if (cfg->slip_confirm_ms > CFG_SLIP_CONFIRM_MAX_MS) {
            return ESP_ERR_INVALID_ARG; /* 0 合法：立即锁，保留旧行为 */
        }
    } else if (strcmp(field, "servo_sim_speed_us_s") == 0) {
        if (cfg->servo_sim_speed_us_s < CFG_SIM_SPEED_MIN ||
            cfg->servo_sim_speed_us_s > CFG_SIM_SPEED_MAX) {
            return ESP_ERR_INVALID_ARG;
        }
    } else if (strcmp(field, "rc_sim_us") == 0) {
        /* 与舵机脉宽同量程：模拟值最终要不经换算地喂进 rc_input，
         * 那里的量程校验就是这一条，两边保持同一个边界 */
        for (int i = 0; i < CFG_RC_CH_COUNT; i++) {
            if (cfg->rc_sim_us[i] < CFG_SERVO_US_MIN || cfg->rc_sim_us[i] > CFG_SERVO_US_MAX) {
                return ESP_ERR_INVALID_ARG;
            }
        }
    } else if (strcmp(field, "cam_policy") == 0) {
        if (cfg->cam_policy > CFG_CAM_POLICY_ALWAYS) {
            return ESP_ERR_INVALID_ARG;
        }
    } else if (strcmp(field, "cam_res") == 0) {
        if (cfg->cam_res > CFG_CAM_RES_SVGA) {
            return ESP_ERR_INVALID_ARG;
        }
    } else if (strcmp(field, "cam_quality") == 0) {
        if (cfg->cam_quality < CFG_CAM_QUALITY_MIN ||
            cfg->cam_quality > CFG_CAM_QUALITY_MAX) {
            return ESP_ERR_INVALID_ARG;
        }
    } else if (strcmp(field, "cam_fps_cap") == 0) {
        if (cfg->cam_fps_cap < CFG_CAM_FPS_MIN || cfg->cam_fps_cap > CFG_CAM_FPS_MAX) {
            return ESP_ERR_INVALID_ARG;
        }
    } else if (strcmp(field, "overlay_mask") == 0) {
        /* 未知位整条拒绝：前端只认低 4 位，固件多收的位只会造成
         * "勾选项存在但没人画"的静默不一致。 */
        if ((cfg->overlay_mask & ~CFG_CAM_OVERLAY_ALL) != 0) {
            return ESP_ERR_INVALID_ARG;
        }
    }
    /* en/sim/sim_rpm/servo_en 为 bool 数组，JSON 解析层负责类型约束 */
    return ESP_OK;
}

/* ---- v1 段（0..31）：两版共用 ---- */

static void pack_v1_segment(const cfg_params_t *cfg, uint8_t *buf)
{
    buf[0] = CFG_PARAMS_BLOB_VERSION;
    buf[1] = (uint8_t)cfg->magnets;
    memcpy(buf + 2, &cfg->wheel_diam_mm, 4);
    memcpy(buf + 6, &cfg->alpha, 4);
    uint8_t en = 0;
    for (int i = 0; i < CFG_WHEEL_COUNT; i++) {
        if (cfg->wheel_enabled[i]) {
            en |= (uint8_t)(1 << i);
        }
    }
    buf[10] = en;
    buf[11] = cfg->sim_on ? 1 : 0;
    memcpy(buf + 12, cfg->sim_rpm, 16);
    memcpy(buf + 28, &cfg->debounce_ms, 4);
}

static void unpack_v1_segment(const uint8_t *buf, cfg_params_t *out)
{
    out->magnets = buf[1];
    memcpy(&out->wheel_diam_mm, buf + 2, 4);
    memcpy(&out->alpha, buf + 6, 4);
    uint8_t en = buf[10];
    for (int i = 0; i < CFG_WHEEL_COUNT; i++) {
        out->wheel_enabled[i] = (en >> i) & 1;
    }
    out->sim_on = buf[11] != 0;
    memcpy(out->sim_rpm, buf + 12, 16);
    memcpy(&out->debounce_ms, buf + 28, 4);
}

/* ---- v3 段（32..75）：舵机与锁定策略 ----
 * v3 比 v2 长 4 字节：脉宽从 min/center/max 三个共享值（6B）
 * 变成每通道两档（8B），后面每个字段的偏移都跟着挪 2 字节。 */

static void pack_v3_segment(const cfg_params_t *cfg, uint8_t *buf)
{
    uint16_t unlock[CFG_SERVO_COUNT];
    uint16_t lock[CFG_SERVO_COUNT];
    uint16_t manual[CFG_SERVO_COUNT];
    uint8_t en = 0;
    for (int i = 0; i < CFG_SERVO_COUNT; i++) {
        unlock[i] = (uint16_t)cfg->servo_unlock_us[i];
        lock[i] = (uint16_t)cfg->servo_lock_us[i];
        manual[i] = (uint16_t)cfg->servo_manual_us[i];
        if (cfg->servo_en[i]) {
            en |= (uint8_t)(1 << i);
        }
    }

    /* buf[34] 只留低 4 位的模式：v2 曾把 invert 位图塞在高 4 位，
     * v3 起高 4 位恒 0（脉宽本身就表达方向，不再需要反向开关） */
    buf[32] = cfg->servo_sim ? 1 : 0;
    buf[33] = en;
    buf[34] = (uint8_t)(cfg->servo_mode & 0x0F);
    memcpy(buf + 35, unlock, 4);
    memcpy(buf + 39, lock, 4);
    memcpy(buf + 43, manual, 4);
    memcpy(buf + 47, &cfg->slip_engage_ratio, 4);
    memcpy(buf + 51, &cfg->slip_min_rpm, 4);
    memcpy(buf + 55, &cfg->lock_hold_ms, 4);
    memcpy(buf + 59, &cfg->lock_hold_max_ms, 4);
    memcpy(buf + 63, &cfg->probe_window_ms, 4);
    memcpy(buf + 67, &cfg->servo_sim_speed_us_s, 4);
    /* 71..75 保留 */
}

static void unpack_v3_segment(const uint8_t *buf, cfg_params_t *out)
{
    uint16_t unlock[CFG_SERVO_COUNT] = {0};
    uint16_t lock[CFG_SERVO_COUNT] = {0};
    uint16_t manual[CFG_SERVO_COUNT] = {0};

    out->servo_sim = buf[32] != 0;
    uint8_t en = buf[33];
    for (int i = 0; i < CFG_SERVO_COUNT; i++) {
        out->servo_en[i] = (en >> i) & 1;
    }
    out->servo_mode = buf[34] & 0x0F;
    memcpy(unlock, buf + 35, 4);
    memcpy(lock, buf + 39, 4);
    memcpy(manual, buf + 43, 4);
    for (int i = 0; i < CFG_SERVO_COUNT; i++) {
        out->servo_unlock_us[i] = unlock[i];
        out->servo_lock_us[i] = lock[i];
        out->servo_manual_us[i] = manual[i];
    }
    memcpy(&out->slip_engage_ratio, buf + 47, 4);
    memcpy(&out->slip_min_rpm, buf + 51, 4);
    memcpy(&out->lock_hold_ms, buf + 55, 4);
    memcpy(&out->lock_hold_max_ms, buf + 59, 4);
    memcpy(&out->probe_window_ms, buf + 63, 4);
    memcpy(&out->servo_sim_speed_us_s, buf + 67, 4);
}

/* v2 → v3 迁移：旧布局只有一组共享的 min/center/max + invert，新布局是
 * 每通道两个落点。旧语义里"解锁 = 中位，锁定 = 偏向 invert 决定的那一端"
 * （即旧映射下 +90° 对应的那一端），照此换算后行为逐位等价，
 * 用户升级不需要重新标定。
 * 偏移刻意照抄 v2 当年的位置写死，不跟 v3 共用——两版从 buf[41] 起就错开了。 */
static void unpack_v2_segment(const uint8_t *buf, cfg_params_t *out)
{
    uint16_t min_us = 0, center_us = 0, max_us = 0;
    uint16_t manual[CFG_SERVO_COUNT] = {0};

    out->servo_sim = buf[32] != 0;
    uint8_t en = buf[33];
    uint8_t inv = (uint8_t)((buf[34] >> 4) & 0x0F);
    for (int i = 0; i < CFG_SERVO_COUNT; i++) {
        out->servo_en[i] = (en >> i) & 1;
    }
    out->servo_mode = buf[34] & 0x0F;
    memcpy(&min_us, buf + 35, 2);
    memcpy(&center_us, buf + 37, 2);
    memcpy(&max_us, buf + 39, 2);
    memcpy(manual, buf + 41, 4);
    for (int i = 0; i < CFG_SERVO_COUNT; i++) {
        out->servo_unlock_us[i] = center_us;
        out->servo_lock_us[i] = ((inv >> i) & 1) ? min_us : max_us;
        out->servo_manual_us[i] = manual[i];
    }
    memcpy(&out->slip_engage_ratio, buf + 45, 4);
    memcpy(&out->slip_min_rpm, buf + 49, 4);
    memcpy(&out->lock_hold_ms, buf + 53, 4);
    memcpy(&out->lock_hold_max_ms, buf + 57, 4);
    memcpy(&out->probe_window_ms, buf + 61, 4);
    memcpy(&out->servo_sim_speed_us_s, buf + 65, 4);
}

/* ---- v4 段（76..83）：遥控输入 ----
 * 追加在 v3 段之后，v1/v3 两段的偏移一个字节都不动：旧固件写下的 blob
 * 在新固件里逐字节可解，新固件写下的 blob 交给旧固件也只会被版本号挡住。 */

static void pack_v4_segment(const cfg_params_t *cfg, uint8_t *buf)
{
    uint16_t sim[CFG_RC_CH_COUNT];
    for (int i = 0; i < CFG_RC_CH_COUNT; i++) {
        sim[i] = (uint16_t)cfg->rc_sim_us[i];
    }
    buf[76] = cfg->rc_sim ? 1 : 0;
    memcpy(buf + 77, sim, sizeof(sim));
    /* 83 保留 */
}

static void unpack_v4_segment(const uint8_t *buf, cfg_params_t *out)
{
    uint16_t sim[CFG_RC_CH_COUNT] = {0};

    out->rc_sim = buf[76] != 0;
    memcpy(sim, buf + 77, sizeof(sim));
    for (int i = 0; i < CFG_RC_CH_COUNT; i++) {
        out->rc_sim_us[i] = sim[i];
    }
}

/* ---- v5 段（84..91）：摄像头 ----
 * 四个单字节字段放前面，末 4 字节是叠加位图。这样 v4 的 0..83 一个字节
 * 都不动，旧固件写的 blob 在新固件里照常解出，升级只补默认值。 */

static void pack_v5_segment(const cfg_params_t *cfg, uint8_t *buf)
{
    buf[84] = (uint8_t)cfg->cam_policy;
    buf[85] = (uint8_t)cfg->cam_res;
    buf[86] = (uint8_t)cfg->cam_quality;
    buf[87] = (uint8_t)cfg->cam_fps_cap;
    memcpy(buf + 88, &cfg->overlay_mask, 4);
}

static void unpack_v5_segment(const uint8_t *buf, cfg_params_t *out)
{
    out->cam_policy = buf[84];
    out->cam_res = buf[85];
    out->cam_quality = buf[86];
    out->cam_fps_cap = buf[87];
    memcpy(&out->overlay_mask, buf + 88, 4);
}

/* ---- v6 段（92..95）：打滑确认期 ----
 * 追加在 v5 段之后，旧段偏移一个字节都不动：旧固件写的 blob 照常解出，
 * 只补一个默认确认期，升级后不会退化成"立即锁"。 */

static void pack_v6_segment(const cfg_params_t *cfg, uint8_t *buf)
{
    memcpy(buf + 92, &cfg->slip_confirm_ms, 4);
}

static void unpack_v6_segment(const uint8_t *buf, cfg_params_t *out)
{
    memcpy(&out->slip_confirm_ms, buf + 92, 4);
}

esp_err_t cfg_params_pack(const cfg_params_t *cfg, uint8_t *buf, size_t len)
{
    if (cfg == NULL || buf == NULL || len < CFG_PARAMS_BLOB_SIZE) {
        return ESP_ERR_INVALID_ARG;
    }
    memset(buf, 0, CFG_PARAMS_BLOB_SIZE);
    pack_v1_segment(cfg, buf);
    pack_v3_segment(cfg, buf);
    pack_v4_segment(cfg, buf);
    pack_v5_segment(cfg, buf);
    pack_v6_segment(cfg, buf);
    return ESP_OK;
}

esp_err_t cfg_params_unpack(const uint8_t *buf, size_t len, cfg_params_t *out)
{
    if (buf == NULL || out == NULL || len == 0) {
        return ESP_ERR_INVALID_ARG;
    }

    /* 先铺默认值：旧版 blob 缺什么字段，新参数就必须落到默认值而不是 0，
     * 否则升级后会得到一组非法配置（如脉宽全 0）。 */
    cfg_params_default(out);

    if (buf[0] == CFG_PARAMS_BLOB_VERSION_1) {
        if (len < CFG_PARAMS_BLOB_SIZE_V1) {
            return ESP_ERR_INVALID_ARG;
        }
        unpack_v1_segment(buf, out);
        return ESP_OK; /* 新版字段保持默认；上层随后回写最新版 */
    }
    if (buf[0] == CFG_PARAMS_BLOB_VERSION_2) {
        if (len < CFG_PARAMS_BLOB_SIZE_V2) {
            return ESP_ERR_INVALID_ARG;
        }
        unpack_v1_segment(buf, out);
        unpack_v2_segment(buf, out); /* 旧布局，按旧语义换算成两档 */
        return ESP_OK;
    }
    if (buf[0] == CFG_PARAMS_BLOB_VERSION_3) {
        if (len < CFG_PARAMS_BLOB_SIZE_V3) {
            return ESP_ERR_INVALID_ARG;
        }
        unpack_v1_segment(buf, out);
        unpack_v3_segment(buf, out);
        return ESP_OK; /* 遥控字段保持默认；上层随后回写最新版 */
    }
    if (buf[0] == CFG_PARAMS_BLOB_VERSION_4) {
        if (len < CFG_PARAMS_BLOB_SIZE_V4) {
            return ESP_ERR_INVALID_ARG;
        }
        unpack_v1_segment(buf, out);
        unpack_v3_segment(buf, out);
        unpack_v4_segment(buf, out);
        return ESP_OK; /* 摄像头字段保持默认；上层随后回写 v5 */
    }
    if (buf[0] == CFG_PARAMS_BLOB_VERSION_5) {
        if (len < CFG_PARAMS_BLOB_SIZE_V5) {
            return ESP_ERR_INVALID_ARG;
        }
        unpack_v1_segment(buf, out);
        unpack_v3_segment(buf, out);
        unpack_v4_segment(buf, out);
        unpack_v5_segment(buf, out);
        return ESP_OK; /* 确认期保持默认 3000ms；上层随后回写 v6 */
    }
    if (buf[0] == CFG_PARAMS_BLOB_VERSION) {
        if (len < CFG_PARAMS_BLOB_SIZE) {
            return ESP_ERR_INVALID_ARG;
        }
        unpack_v1_segment(buf, out);
        unpack_v3_segment(buf, out);
        unpack_v4_segment(buf, out);
        unpack_v5_segment(buf, out);
        unpack_v6_segment(buf, out);
        return ESP_OK;
    }
    return ESP_ERR_INVALID_VERSION;
}
