Yin-bo-de/wheel_speed_monitor/main/config_params.h

/*
 * config_params：车载运行参数的纯 C 模型，宿主机可测（无 IDF 依赖）。
 * 配置存储由 main 的 config_store 负责（NVS 薄封装），这里只做：
 * 默认值、逐字段校验、NVS blob 打包/解包。
 *
 * blob 版本迁移：v1（32B）是一期的布局；v2（72B）在尾部追加舵机与锁定策略
 * 参数；v3（76B）把舵机脉宽从"共享的 min/center/max + invert"换成"每通道的
 * 解锁/锁定两档"；v4（84B）在尾部追加遥控输入（模拟开关与三路模拟脉宽）；
 * v5（92B）在尾部追加摄像头策略、分辨率、画质、采集/发送帧率上限与叠加位图；
 * v6（96B）在尾部追加打滑确认期（首次判定打滑后需连续满足多久才上锁）。
 * 解包按首字节版本号分派——旧 blob 仍可解，缺失字段取默认值（v2 还要按旧
 * 语义换算，见 cfg_params_unpack），上层解出后回写最新版，升级不丢用户已设的配置。
 */
#ifndef CONFIG_PARAMS_H
#define CONFIG_PARAMS_H

#include <stdbool.h>
#include <stddef.h>
#include <stdint.h>

#include "esp_err.h"

#ifdef __cplusplus
extern "C" {
#endif

#define CFG_WHEEL_COUNT 4
#define CFG_SERVO_COUNT 2 /* 0=前差速 1=后差速 */
#define CFG_RC_CH_COUNT 3 /* 遥控三路：0=模式 1=前差速 2=后差速（与 rc_input 顺序一致） */

#define CFG_MAGNETS_MIN 1
#define CFG_MAGNETS_MAX 16
#define CFG_DIAM_MM_MIN 10
#define CFG_DIAM_MM_MAX 300
#define CFG_ALPHA_MIN 0.05f
#define CFG_ALPHA_MAX 1.0f

/* 舵机脉宽：标准角度舵机的常见量程，两端各留余量 */
#define CFG_SERVO_US_MIN 500
#define CFG_SERVO_US_MAX 2500

#define CFG_SERVO_MODE_MANUAL 0
#define CFG_SERVO_MODE_AUTO 1

#define CFG_SLIP_ENGAGE_MIN 0.05f
#define CFG_SLIP_MIN_RPM_MAX 2000.0f

#define CFG_LOCK_HOLD_MIN_MS 200
#define CFG_LOCK_HOLD_MAX_MS 60000
#define CFG_PROBE_WINDOW_MIN_MS 200
#define CFG_PROBE_WINDOW_MAX_MS 10000
/* 打滑确认期上限 60s；下限 0 = 立即上锁（保留旧行为） */
#define CFG_SLIP_CONFIRM_MAX_MS 60000
#define CFG_SIM_SPEED_MIN 100
#define CFG_SIM_SPEED_MAX 20000

/* 摄像头策略：off 永不初始化；on_demand 由第一个流/快照请求启动；always 调试常开。 */
#define CFG_CAM_POLICY_OFF 0
#define CFG_CAM_POLICY_ON_DEMAND 1
#define CFG_CAM_POLICY_ALWAYS 2

#define CFG_CAM_RES_QVGA 0
#define CFG_CAM_RES_VGA 1
#define CFG_CAM_RES_SVGA 2

#define CFG_CAM_QUALITY_MIN 4
#define CFG_CAM_QUALITY_MAX 63
#define CFG_CAM_FPS_MIN 5
#define CFG_CAM_FPS_MAX 25

/* 叠加位图：低 4 位有定义，其余位一律拒绝，避免"页面以为开了、固件不认识"。 */
#define CFG_CAM_OVERLAY_WHEELS (1u << 0)
#define CFG_CAM_OVERLAY_SERVO (1u << 1)
#define CFG_CAM_OVERLAY_RC (1u << 2)
#define CFG_CAM_OVERLAY_SYS (1u << 3)
#define CFG_CAM_OVERLAY_ALL (CFG_CAM_OVERLAY_WHEELS | CFG_CAM_OVERLAY_SERVO | \
                             CFG_CAM_OVERLAY_RC | CFG_CAM_OVERLAY_SYS)

/* blob 定长布局（尾部补零）：
 *   v1 段 0..31：版本(1B) + magnets(1B) + diam(4B) + alpha(4B float)
 *               + wheel_enabled(1B 位图) + sim_on(1B) + sim_rpm[4](16B) + debounce_ms(4B)
 *   v3 段 32..75：servo_sim(1B) + servo_en(1B 位图) + servo_mode(1B)
 *               + unlock_us(u16×2) + lock_us(u16×2) + manual_us(u16×2)
 *               + engage/min_rpm(float×2) + lock_hold/max/probe(u32×3)
 *               + sim_speed(u32) + 保留(5B)
 *   v4 段 76..83：rc_sim(1B) + rc_sim_us(u16×3) + 保留(1B)
 *   v5 段 84..91：cam_policy(1B) + cam_res(1B) + cam_quality(1B)
 *               + cam_fps_cap(1B) + overlay_mask(u32)
 *   v6 段 92..95：slip_confirm_ms(u32)
 * v2 段（32..71）与 v3 段是同义不同形：v2 用共享的 min/center/max + invert
 * 位图描述脉宽，v3 换成每通道两档，因此长 4 字节、其余字段偏移整体后移。 */
#define CFG_PARAMS_BLOB_VERSION 6
#define CFG_PARAMS_BLOB_SIZE 96
#define CFG_PARAMS_BLOB_VERSION_1 1
#define CFG_PARAMS_BLOB_SIZE_V1 32
#define CFG_PARAMS_BLOB_VERSION_2 2
#define CFG_PARAMS_BLOB_SIZE_V2 72
#define CFG_PARAMS_BLOB_VERSION_3 3
#define CFG_PARAMS_BLOB_SIZE_V3 76
#define CFG_PARAMS_BLOB_VERSION_4 4
#define CFG_PARAMS_BLOB_SIZE_V4 84
#define CFG_PARAMS_BLOB_VERSION_5 5
#define CFG_PARAMS_BLOB_SIZE_V5 92

typedef struct {
    uint32_t magnets;    /* 每转磁铁数 1-16 */
    uint32_t wheel_diam_mm; /* 轮径（毫米）10-300 */
    float alpha;         /* EMA 系数 0.05-1.0 */
    bool wheel_enabled[CFG_WHEEL_COUNT];
    bool sim_on;         /* 模拟模式总开关 */
    float sim_rpm[CFG_WHEEL_COUNT];
    uint32_t debounce_ms; /* 最小脉冲间隔去抖；0=关闭 */

    /* ---- v2：差速舵机（v3 起脉宽改为每通道两档） ---- */
    bool servo_sim; /* true=模拟舵机模型；false=LEDC 驱动真实舵机 */
    bool servo_en[CFG_SERVO_COUNT];
    /* 自动模式只有这两个落点，前后轴各配一组：差速器的锁止/释放是两个确定的
     * 机械位置，中间行程没有意义。反装的舵机把两档改填到行程另一端即可，
     * 不必再引入一个"反向"开关。 */
    uint32_t servo_unlock_us[CFG_SERVO_COUNT]; /* 解锁档（正常行驶位置） */
    uint32_t servo_lock_us[CFG_SERVO_COUNT];   /* 锁定档（差速锁死位置） */
    uint32_t servo_mode;                       /* CFG_SERVO_MODE_* */
    uint32_t servo_manual_us[CFG_SERVO_COUNT]; /* 手动模式目标脉宽 */

    /* ---- v2：打滑判定与锁定策略 ---- */
    float slip_engage_ratio;   /* 打滑进入门槛 */
    float slip_min_rpm;        /* 低于此转速不判定 */
    uint32_t lock_hold_ms;     /* 初始锁定保持时长（"地形时间"） */
    uint32_t lock_hold_max_ms; /* 保持时长翻倍上限 */
    uint32_t probe_window_ms;  /* 试探窗口：车连续动满此时长才算脱困 */
    uint32_t servo_sim_speed_us_s; /* 模拟舵机行程速率（µs/秒） */

    /* ---- v4：遥控输入 ---- */
    bool rc_sim; /* true=注入模拟遥控信号；false=读 GPIO 上的真实捕获 */
    /* 三路模拟脉宽，顺序同 rc_input：模式 / 前差速 / 后差速。
     * 模式通道默认落在自动区（1000），打开模拟不会平白把模式翻成手动。 */
    uint32_t rc_sim_us[CFG_RC_CH_COUNT];

    /* ---- v5：摄像头 ---- */
    uint32_t cam_policy;    /* CFG_CAM_POLICY_*，默认 on_demand */
    uint32_t cam_res;       /* CFG_CAM_RES_*，默认 QVGA */
    uint32_t cam_quality;   /* JPEG quality 4..63，值小画质高 */
    uint32_t cam_fps_cap;   /* 采集/发送帧率上限 5..25；传感器支持时直接降采集帧率 */
    uint32_t overlay_mask;  /* CFG_CAM_OVERLAY_* 位图 */

    /* ---- v6：打滑确认 ---- */
    uint32_t slip_confirm_ms; /* 首次打滑后需连续满足多久才上锁；0=立即锁 */
} cfg_params_t;

void cfg_params_default(cfg_params_t *cfg);

/* 校验单字段；字段名与 JSON 命令一致（magnets、diam、alpha、en、sim、
 * sim_rpm、debounce，以及 v2 的舵机与锁定策略各字段、v6 的 slip_confirm_ms，
 * 见上表）。
 * 未知字段返回 ESP_OK（命令层忽略）。
 * 跨字段约束（min<center<max、hold_max>=hold）随任一相关字段被写时一并检查，
 * 前端整组提交即保持一致。 */
esp_err_t cfg_params_validate(const cfg_params_t *cfg, const char *field);

/* v1 与 v2 两种长度的 blob 都可解（按首字节版本号分派）。 */
esp_err_t cfg_params_unpack(const uint8_t *buf, size_t len, cfg_params_t *out);

esp_err_t cfg_params_pack(const cfg_params_t *cfg, uint8_t *buf, size_t len);

#ifdef __cplusplus
}
#endif

#endif /* CONFIG_PARAMS_H */
