Yin-bo-de/wheel_speed_monitor/main/bench_cam.c

/* bench_cam 实现：见头文件与 docs/CAMERA_DESIGN.md 4.5.1。 */
#include <string.h>

#include "bench_cam.h"

#include "cam_rate.h"
#include "camera_drv.h"
#include "esp_heap_caps.h"
#include "esp_log.h"
#include "esp_timer.h"
#include "freertos/task.h"

#include "wheel_config.h"

static const char *TAG = "benchcam";

/* 控制器是独立纯 C 组件，帧率边界必须和配置校验保持一致。 */
_Static_assert(CAM_RATE_FPS_MIN == CFG_CAM_FPS_MIN, "cam_rate min fps mismatch");
_Static_assert(CAM_RATE_FPS_MAX == CFG_CAM_FPS_MAX, "cam_rate max fps mismatch");
_Static_assert(CAM_QUALITY_MIN == CFG_CAM_QUALITY_MIN, "quality min mismatch");
_Static_assert(CAM_QUALITY_MAX == CFG_CAM_QUALITY_MAX, "quality max mismatch");

#define CAM_IDLE_POLL_MS 20
#define CAM_PREVIEW_HOLD_MS 30000
#define CAM_STREAM_GRACE_MS 30000
#define CAM_FAIL_LIMIT 3
/* 7 帧只有 0.5 秒，一次抢占就能把基准拉偏；20 帧把偶发抖动摊薄，
 * 仍然是按需预览可接受的启动等待（默认帧率下约 1.3 秒）。 */
#define CAM_FPS_CALIB_FRAMES 20
/* init 后 AEC/AGC 还在收敛，暗环境前几帧曝光时间长，先丢几帧再测。 */
#define CAM_FPS_CALIB_SETTLE_FRAMES 5
/* 限速状态下测不到真实基准：目标低于 base 时传感器被分频拉低。
 * 定期恢复默认时序重测，跟踪光照变化。 */
#define CAM_BASE_RECAL_MS 30000
/* 重测切换寄存器后先丢几帧，等新时序稳定。 */
#define CAM_FPS_RECAL_SETTLE_FRAMES 3
/* 未限速时实际帧率就是基准，和采集日志共用 5 秒窗口观测更新。 */
#define CAM_BASE_OBSERVE_MS 5000
#define CAM_DEADLINE_NONE UINT32_MAX

typedef enum {
    CAM_OFF = 0,
    CAM_IDLE,
    CAM_INIT,
    CAM_ON,
    CAM_FAIL,
} cam_state_t;

typedef enum {
    ACT_NONE = 0,
    ACT_INIT,
    ACT_DEINIT,
    ACT_SET_FPS,
    ACT_GRAB,
} cam_action_t;

static cfg_params_t *s_cfg;
static SemaphoreHandle_t s_cfg_mutex;
static SemaphoreHandle_t s_lock;

/* 以下状态都归 s_lock 保护（相机驱动句柄本身只归 cam_publish_task）。 */
static cam_state_t s_state = CAM_IDLE;
static uint32_t s_applied_policy = CFG_CAM_POLICY_ON_DEMAND;
static uint32_t s_applied_res = CFG_CAM_RES_QVGA;
static uint32_t s_applied_quality = 12; /* 用户配置值 */
/* 自适应画质：帧率到下限仍拥堵时提高 quality 数值（压缩更强、帧更小），
 * 网络恢复后还回用户配置。决策在纯 C 的 cam_quality 里，本文件只负责
 * 把结果写进传感器。 */
static cam_quality_t s_quality;
static bool s_quality_pending; /* 待 cam_publish_task 写入传感器 */
static bool s_quality_auto_ok = true;
static uint32_t s_quality_fail_count;
/* 连续写失败这么多次就停掉自适应画质，避免每轮循环都去打扰 SCCB。 */
#define CAM_QUALITY_FAIL_LIMIT 3
static uint32_t s_cached_overlay = CFG_CAM_OVERLAY_ALL;
static cam_rate_t s_rate;
/* 用户在设置页配的上限。控制器实际用的上限还要和实测 base 取小，
 * 否则目标会抬到传感器达不到的帧率。 */
static uint32_t s_user_fps_cap = CFG_CAM_FPS_MAX;

/* 流任务句柄：发布新帧后直接通知它，发送节奏锁定到传感器出帧。
 * 只由流任务在启动时写一次，指针读写是原子的，不需要加锁。 */
static TaskHandle_t s_frame_wait_task;

static bool s_preview_active;
static bool s_stream_active;
static bool s_stop_stream;
static bool s_init_requested;
static bool s_reinit_requested;
/* OTA 挂起：httpd 任务写，cam_task 每轮在锁内读取。 */
static bool s_ota_suspend;
static uint32_t s_preview_deadline = CAM_DEADLINE_NONE;
static uint32_t s_grace_deadline = CAM_DEADLINE_NONE;

static uint8_t *s_pub;
static size_t s_pub_cap;
static size_t s_frame_len;
static uint32_t s_frame_gen;
static uint32_t s_last_frame_ms;
static float s_fps;
static uint32_t s_fps_window_ms;
static uint32_t s_fps_frames;
/* 采集帧率日志用独立的 5 秒窗口，和 camstream 的发送窗口同口径；
 * s_fps 仍按 1 秒窗口更新，遥测页面要的是及时性。 */
static uint32_t s_fps_log_start_ms;
static uint32_t s_fps_log_frames;
static uint32_t s_fail_count;
static uint32_t s_big_frame_drops; /* 帧大于发布缓冲：限频打印，别刷日志 */

/* 传感器帧率控制。基准帧率在初始化后实测，之后按目标/基准换算寄存器；
 * 传感器不支持时退回"按目标节奏取帧"，至少不让 DMA/拷贝继续全速跑。
 *
 * base 会随光照、AEC 曝光时间变化，不能只测一次：未限速时用实际帧率
 * 滚动更新；限速时定期恢复默认时序重测。 */
static uint32_t s_base_fps;
/* base 是单向下行的棘轮：一旦被误拉低，target 跟着低，观测就再也回不到
 * 原来的值。下降要连续两个 5 秒窗口确认，单次抖动只记一笔。 */
#define CAM_BASE_LOW_CONFIRM 2
static uint32_t s_base_low_streak;
static uint32_t s_sensor_fps_applied;
static bool s_fps_calibrated;
static bool s_sensor_fps_ok;
static bool s_calib_active;                        /* 采样窗口进行中 */
static uint32_t s_calib_settle;                    /* 还要丢几帧 */
static uint32_t s_calib_last_grab_ms;
static uint32_t s_calib_gap_count;
static uint32_t s_calib_gaps[CAM_FPS_CALIB_FRAMES - 1];
static uint32_t s_base_last_ms;                    /* 上次校准/观测更新时刻 */
static bool s_base_dirty;                          /* base 变了，待重设限速 */
static uint32_t s_next_grab_ms;

static uint32_t now_ms(void)
{
    return xTaskGetTickCount() * portTICK_PERIOD_MS;
}

static void lock(void)
{
    xSemaphoreTake(s_lock, portMAX_DELAY);
}

static void unlock(void)
{
    xSemaphoreGive(s_lock);
}

static bool deadline_due(uint32_t now, uint32_t deadline)
{
    return deadline != CAM_DEADLINE_NONE && (int32_t)(now - deadline) >= 0;
}

/* 调用时 s_lock 已持有。上限取用户配置和传感器实测基准的较小值：
 * 目标高于 base 时驱动只会保持基准，控制器再往上抬没有意义。 */
static void apply_rate_cap_locked(void)
{
    uint32_t cap = s_user_fps_cap;
    if (s_base_fps != 0 && s_base_fps < cap) {
        cap = s_base_fps;
    }
    cam_rate_set_cap(&s_rate, cap);
}

/* 相机重新开始或用户改配置：自适应画质回到用户值，失败计数清零。 */
static void reset_quality_state(uint8_t user_quality)
{
    cam_quality_init(&s_quality, user_quality);
    s_quality_pending = false;
    s_quality_auto_ok = true;
    s_quality_fail_count = 0;
}

/* 每 5 秒评估一次，调用时 s_lock 已持有。返回 true 表示画质变了。 */
static bool adapt_quality_locked(void)
{
    return cam_quality_evaluate(&s_quality, s_rate.stream_active,
                                s_rate.last_avg_valid,
                                cam_rate_effective(&s_rate),
                                cam_rate_cap(&s_rate),
                                s_rate.last_avg_ms);
}

static const char *state_str(cam_state_t st)
{
    switch (st) {
    case CAM_OFF:
        return "off";
    case CAM_IDLE:
        return "idle";
    case CAM_INIT:
        return "init";
    case CAM_ON:
        return "on";
    case CAM_FAIL:
    default:
        return "fail";
    }
}

static const char *policy_str(uint32_t policy)
{
    switch (policy) {
    case CFG_CAM_POLICY_OFF:
        return "off";
    case CFG_CAM_POLICY_ALWAYS:
        return "always";
    case CFG_CAM_POLICY_ON_DEMAND:
    default:
        return "on_demand";
    }
}

static const char *res_str(uint32_t res)
{
    switch (res) {
    case CFG_CAM_RES_VGA:
        return "vga";
    case CFG_CAM_RES_SVGA:
        return "svga";
    case CFG_CAM_RES_QVGA:
    default:
        return "qvga";
    }
}

/* 读配置只拷 cam 相关字段：相机任务不应该因为别的参数变化去碰 NVS/业务结构。 */
static bool read_cam_cfg(uint32_t *policy, uint32_t *res, uint32_t *quality,
                         uint32_t *fps_cap, uint32_t *overlay)
{
    if (s_cfg == NULL || s_cfg_mutex == NULL) {
        return false;
    }
    if (xSemaphoreTake(s_cfg_mutex, pdMS_TO_TICKS(100)) != pdTRUE) {
        return false;
    }
    *policy = s_cfg->cam_policy;
    *res = s_cfg->cam_res;
    *quality = s_cfg->cam_quality;
    *fps_cap = s_cfg->cam_fps_cap;
    *overlay = s_cfg->overlay_mask;
    xSemaphoreGive(s_cfg_mutex);
    return true;
}

/* 调用时 s_lock 已持有。 */
static void free_pub_locked(void)
{
    if (s_pub != NULL) {
        heap_caps_free(s_pub);
        s_pub = NULL;
    }
    s_pub_cap = 0;
    s_frame_len = 0;
    s_frame_gen++;
    s_last_frame_ms = 0;
    s_fps = 0.0f;
    s_fps_window_ms = 0;
    s_fps_frames = 0;
    /* 相机停过一段时间再启动，旧窗口会把空闲时间算进平均帧率。 */
    s_fps_log_start_ms = 0;
    s_fps_log_frames = 0;
}

/* 调用时 s_lock 已持有；只负责清运行时缓冲和状态，不碰相机句柄。 */
static void set_idle_locked(cam_state_t target)
{
    free_pub_locked();
    s_state = target;
    s_fail_count = 0;
    s_reinit_requested = false;
    s_preview_deadline = CAM_DEADLINE_NONE;
    s_grace_deadline = CAM_DEADLINE_NONE;
    if (target == CAM_OFF) {
        s_init_requested = false;
        s_stop_stream = true;
    }
}

static bool alloc_pub_locked(uint32_t res)
{
    size_t cap = camera_drv_max_jpeg(res);
    uint8_t *p = heap_caps_malloc(cap, MALLOC_CAP_SPIRAM | MALLOC_CAP_8BIT);
    if (p == NULL) {
        ESP_LOGE(TAG, "PSRAM publish buffer alloc failed (%u B)", (unsigned)cap);
        return false;
    }
    s_pub = p;
    s_pub_cap = cap;
    s_frame_len = 0;
    s_frame_gen++;
    return true;
}

static void publish_frame(const camera_drv_frame_t *frame, uint32_t now)
{
    bool published = false;
    bool log_fps = false;
    bool log_base = false;
    float fps_snapshot = 0.0f;
    uint32_t target_snapshot = 0;
    uint32_t cap_snapshot = 0;
    uint32_t base_log_old = 0;
    uint32_t base_log_new = 0;
    bool log_quality = false;
    uint32_t quality_log_old = 0;
    uint32_t quality_log_new = 0;
    uint32_t avg_send_snapshot = 0;
    lock();
    /* 能拿到帧就说明传感器还在出数据，失败计数清零；帧太大只是发布缓冲
     * 不够，不该和"取帧超时"混成同一个故障。 */
    s_fail_count = 0;
    if (s_pub != NULL && frame->len <= s_pub_cap) {
        memcpy(s_pub, frame->data, frame->len);
        s_frame_len = frame->len;
        s_frame_gen++;
        s_last_frame_ms = now;
        published = true;

        if (s_fps_window_ms == 0) {
            s_fps_window_ms = now;
            s_fps_frames = 0;
        }
        s_fps_frames++;
        if (s_fps_log_start_ms == 0) {
            s_fps_log_start_ms = now;
            s_fps_log_frames = 0;
        }
        s_fps_log_frames++;

        uint32_t elapsed = now - s_fps_window_ms;
        if (elapsed >= 1000) {
            s_fps = (float)s_fps_frames * 1000.0f / (float)elapsed;
            s_fps_window_ms = now;
            s_fps_frames = 0;
            /* 采集侧实测。和 camstream 的 stream 日志对齐看：grab 低是采集，
             * grab 正常而 send 低是网络。 */
            uint32_t log_elapsed = now - s_fps_log_start_ms;
            if (log_elapsed >= CAM_BASE_OBSERVE_MS) {
                log_fps = true;
                fps_snapshot = (float)s_fps_log_frames * 1000.0f / (float)log_elapsed;
                s_fps_log_start_ms = now;
                s_fps_log_frames = 0;
                target_snapshot = cam_rate_effective(&s_rate);
                cap_snapshot = cam_rate_cap(&s_rate);

                /* 未限速时 grab 就是当前基准帧率，滚动更新以跟光照变化。
                 * 限速时 grab 等于目标，不能拿来更新，否则会把 base 越拉越低。 */
                if (s_fps_calibrated && s_sensor_fps_ok && !s_calib_active &&
                    target_snapshot >= s_base_fps) {
                    uint32_t observed = (uint32_t)(fps_snapshot + 0.5f);
                    /* 1fps 的统计抖动不算能力变化，否则 base/cap/target
                     * 会在 11/12 之间来回刷，日志和 VTS 都跟着抖。 */
                    uint32_t diff = observed > s_base_fps
                                        ? observed - s_base_fps
                                        : s_base_fps - observed;
                    if (observed >= 1 && diff >= 2) {
                        if (observed < s_base_fps &&
                            s_base_low_streak < CAM_BASE_LOW_CONFIRM) {
                            s_base_low_streak++;
                        } else {
                            base_log_old = s_base_fps;
                            base_log_new = observed;
                            s_base_fps = observed;
                            s_base_last_ms = now;
                            s_base_dirty = true;
                            s_base_low_streak = 0;
                            apply_rate_cap_locked();
                            /* 上限可能刚被压低，日志按夹后的值打印 */
                            target_snapshot = cam_rate_effective(&s_rate);
                            cap_snapshot = cam_rate_cap(&s_rate);
                            log_base = true;
                        }
                    } else {
                        s_base_low_streak = 0;
                    }
                }

                if (s_quality_auto_ok) {
                    uint32_t q_before = s_quality.effective;
                    if (adapt_quality_locked()) {
                        log_quality = true;
                        quality_log_old = q_before;
                        quality_log_new = s_quality.effective;
                        avg_send_snapshot = s_rate.last_avg_ms;
                    }
                    /* 目标值和传感器实际值不一致：上次写失败，等下一个
                     * 5 秒窗口再试，不要在循环里反复打扰 SCCB。 */
                    if (s_quality.effective != s_quality.applied) {
                        s_quality_pending = true;
                    }
                }
            }
        }
    } else if (s_pub != NULL && frame->len > s_pub_cap) {
        if ((s_big_frame_drops++ % 60u) == 0) {
            ESP_LOGW(TAG, "frame %u B exceeds publish buffer %u B, dropped",
                     (unsigned)frame->len, (unsigned)s_pub_cap);
        }
    }
    unlock();

    if (log_fps) {
        ESP_LOGI(TAG, "grab fps=%.1f target=%lu cap=%lu pacing=%s",
                 fps_snapshot, (unsigned long)target_snapshot,
                 (unsigned long)cap_snapshot, s_sensor_fps_ok ? "sensor" : "grab");
    }
    if (log_base) {
        ESP_LOGI(TAG, "base observed: %lu -> %lu fps",
                 (unsigned long)base_log_old, (unsigned long)base_log_new);
    }
    if (log_quality) {
        ESP_LOGI(TAG, "auto quality: %lu -> %lu (user %lu, avg_send %lu ms)",
                 (unsigned long)quality_log_old, (unsigned long)quality_log_new,
                 (unsigned long)s_applied_quality, (unsigned long)avg_send_snapshot);
    }

    /* 通知放在锁外：发送侧不在锁内做任何事，这里也不持锁做调度操作。
     * 没有流时通知会累积计数，流任务开始发送前会清一次。 */
    if (published && s_frame_wait_task != NULL) {
        xTaskNotifyGive(s_frame_wait_task);
    }
}

/* 相机每次 init/deinit/失败都从头校准；这些状态只归 cam_task 使用。 */
static void reset_calib_state(void)
{
    s_fps_calibrated = false;
    s_sensor_fps_ok = false;
    s_sensor_fps_applied = 0;
    s_base_fps = 0;
    s_calib_active = false;
    s_calib_settle = 0;
    s_calib_last_grab_ms = 0;
    s_calib_gap_count = 0;
    s_base_last_ms = 0;
    s_base_dirty = false;
    s_base_low_streak = 0;
    s_next_grab_ms = 0;
}

/* 帧间隔取中位数换算帧率：比总时间平均抗启动抖动和偶发长尾。 */
static uint32_t fps_from_median_gap(uint32_t *gaps, uint32_t count)
{
    for (uint32_t i = 1; i < count; i++) {
        uint32_t v = gaps[i];
        uint32_t j = i;
        while (j > 0 && gaps[j - 1] > v) {
            gaps[j] = gaps[j - 1];
            j--;
        }
        gaps[j] = v;
    }
    uint32_t med = gaps[count / 2];
    if (med == 0) {
        med = 1;
    }
    uint32_t fps = (1000u + med / 2u) / med;
    if (fps < 1) {
        fps = 1;
    }
    if (fps > 60) {
        fps = 60;
    }
    return fps;
}

static void start_calib_sampling(uint32_t settle_frames)
{
    s_calib_active = true;
    s_calib_settle = settle_frames;
    s_calib_gap_count = 0;
    s_calib_last_grab_ms = 0;
}

static void finish_calib(uint32_t grab_ms, bool was_recal)
{
    uint32_t base = fps_from_median_gap(s_calib_gaps, CAM_FPS_CALIB_FRAMES - 1);
    uint32_t old = s_base_fps;
    s_base_fps = base;
    s_fps_calibrated = true;
    s_calib_active = false;
    s_base_last_ms = grab_ms;
    s_base_dirty = false;

    uint32_t target;
    lock();
    apply_rate_cap_locked();
    target = cam_rate_effective(&s_rate);
    unlock();

    esp_err_t e = camera_drv_set_fps(s_base_fps, target);
    if (e == ESP_OK) {
        s_sensor_fps_applied = target; /* 目标高于 base 时驱动保持基准 */
        if (was_recal) {
            ESP_LOGI(TAG, "base recalibrated: %lu -> %lu fps (target %lu)",
                     (unsigned long)old, (unsigned long)base, (unsigned long)target);
        } else {
            ESP_LOGI(TAG, "base calibrated: %lu fps (target %lu)",
                     (unsigned long)base, (unsigned long)target);
        }
    } else {
        s_sensor_fps_ok = false;
        ESP_LOGW(TAG, "sensor fps set failed (%d), fall back to grab pacing", e);
    }
}

/* 先丢几帧让 AEC/AGC 收敛，再用随后 20 帧的帧间隔中位数测基准帧率。
 * 未限速时实际帧率就是基准，由 publish_frame 的 5 秒窗口滚动更新；
 * 限速时这里定期恢复默认时序重测，跟踪光照变化。 */
static void calibrate_sensor_fps(uint32_t grab_ms)
{
    if (!s_sensor_fps_ok) {
        return;
    }

    uint32_t eff;
    lock();
    eff = cam_rate_effective(&s_rate);
    unlock();

    if (!s_calib_active && s_fps_calibrated && eff < s_base_fps &&
        (uint32_t)(grab_ms - s_base_last_ms) >= CAM_BASE_RECAL_MS) {
        esp_err_t e = camera_drv_reset_fps();
        if (e == ESP_OK) {
            /* 重测期间传感器跑默认帧率，发送侧仍按 effective 限速，画面
             * 不会加速；清掉窗口统计，避免采集变化被误判成网络变化。 */
            lock();
            cam_rate_reset_window(&s_rate);
            unlock();
            start_calib_sampling(CAM_FPS_RECAL_SETTLE_FRAMES);
            s_base_dirty = false;
            ESP_LOGI(TAG, "base recal start: target=%lu base=%lu",
                     (unsigned long)eff, (unsigned long)s_base_fps);
            return;
        }
        /* 失败也推迟到下一轮，别每帧重试 */
        s_base_last_ms = grab_ms;
        ESP_LOGW(TAG, "base recal reset failed: %d", e);
    }

    if (!s_calib_active) {
        if (!s_fps_calibrated) {
            start_calib_sampling(CAM_FPS_CALIB_SETTLE_FRAMES);
        } else {
            return;
        }
    }

    if (s_calib_settle > 0) {
        s_calib_settle--;
        return;
    }
    if (s_calib_last_grab_ms == 0) {
        s_calib_last_grab_ms = grab_ms;
        return;
    }

    uint32_t gap = grab_ms - s_calib_last_grab_ms;
    s_calib_last_grab_ms = grab_ms;
    if (gap == 0) {
        return;
    }
    s_calib_gaps[s_calib_gap_count++] = gap;
    if (s_calib_gap_count < CAM_FPS_CALIB_FRAMES - 1) {
        return;
    }

    finish_calib(grab_ms, s_fps_calibrated);
}

/* 传感器不支持控速时的兜底：按有效帧率决定下一次取帧时间。 */
static void pace_next_grab(void)
{
    if (s_sensor_fps_ok) {
        return;
    }
    uint32_t eff;
    lock();
    eff = cam_rate_effective(&s_rate);
    unlock();
    if (eff == 0) {
        eff = 1;
    }
    uint32_t interval = 1000u / eff;
    if (interval == 0) {
        interval = 1;
    }
    s_next_grab_ms = now_ms() + interval;
}

static void cam_task(void *arg)
{
    (void)arg;
    camera_drv_frame_t frame;

    for (;;) {
        uint32_t now = now_ms();
        uint32_t cfg_policy, cfg_res, cfg_quality, cfg_fps_cap, cfg_overlay;
        bool have_cfg = read_cam_cfg(&cfg_policy, &cfg_res, &cfg_quality,
                                     &cfg_fps_cap, &cfg_overlay);

        cam_action_t action = ACT_NONE;
        bool idle_to_off = false;
        uint32_t init_res = 0, init_quality = 0;
        uint32_t fps_to_apply = 0;
        uint32_t quality_to_apply = 0;

        lock();

        /* 自适应画质的寄存器写入只能在相机任务里做，评估在发布帧时完成。 */
        if (s_quality_pending && s_state == CAM_ON && !s_ota_suspend) {
            quality_to_apply = s_quality.effective;
            s_quality_pending = false;
        }

        if (have_cfg) {
            s_cached_overlay = cfg_overlay;
            if (cfg_fps_cap != s_user_fps_cap) {
                s_user_fps_cap = cfg_fps_cap;
                apply_rate_cap_locked();
                ESP_LOGI(TAG, "fps cap -> %lu (user %lu, base %lu)",
                         (unsigned long)cam_rate_cap(&s_rate),
                         (unsigned long)s_user_fps_cap,
                         (unsigned long)s_base_fps);
            }

            if (cfg_policy != s_applied_policy) {
                ESP_LOGI(TAG, "policy %s -> %s", policy_str(s_applied_policy),
                         policy_str(cfg_policy));
                s_applied_policy = cfg_policy;
                if (cfg_policy == CFG_CAM_POLICY_OFF) {
                    s_stop_stream = true;
                    action = ACT_DEINIT;
                    idle_to_off = true;
                } else if (cfg_policy == CFG_CAM_POLICY_ALWAYS) {
                    s_preview_deadline = CAM_DEADLINE_NONE;
                    s_grace_deadline = CAM_DEADLINE_NONE;
                    apply_rate_cap_locked();
                    if (s_state != CAM_ON && s_state != CAM_INIT) {
                        s_init_requested = true;
                    }
                } else { /* on_demand */
                    if (s_state == CAM_OFF) {
                        s_state = CAM_IDLE;
                    }
                    if (s_state == CAM_ON) {
                        if (s_stream_active) {
                            if (!s_preview_active) {
                                s_preview_deadline = now + CAM_PREVIEW_HOLD_MS;
                            }
                        } else {
                            s_grace_deadline = now + CAM_STREAM_GRACE_MS;
                        }
                    }
                }
            }

            if (cfg_res != s_applied_res || cfg_quality != s_applied_quality) {
                s_applied_res = cfg_res;
                s_applied_quality = cfg_quality;
                /* 用户改了画质就把自适应偏移清零，新配置是新的基准。 */
                reset_quality_state((uint8_t)cfg_quality);
                /* 有流或 always：立即重 init，旧流由流任务结束；没有流且不在
                 * 采集中：先回 idle，等下一次请求按新参数 init。 */
                if (s_state == CAM_ON || s_state == CAM_INIT) {
                    if (s_stream_active || s_applied_policy == CFG_CAM_POLICY_ALWAYS) {
                        s_reinit_requested = true;
                        s_stop_stream = true;
                    } else if (action == ACT_NONE) {
                        action = ACT_DEINIT;
                        idle_to_off = false;
                    }
                }
            }
        }

        /* OTA 期间压住一切相机启动。升级在上传 handler 里同步跑，
         * flash 写会停 cache，相机 DMA 和 MJPEG 发送都会跟着卡。 */
        if (s_ota_suspend) {
            s_init_requested = false;
            s_reinit_requested = false;
            s_stop_stream = true;
            s_preview_deadline = CAM_DEADLINE_NONE;
            s_grace_deadline = CAM_DEADLINE_NONE;
            if (action == ACT_INIT) {
                action = ACT_NONE; /* 这一轮不要启动相机 */
            }
            if (s_state != CAM_OFF) {
                action = ACT_DEINIT;
                idle_to_off = true;
            }
        }

        if (action == ACT_NONE && s_applied_policy == CFG_CAM_POLICY_OFF &&
            s_state != CAM_OFF) {
            action = ACT_DEINIT;
            idle_to_off = true;
        }

        if (action == ACT_NONE && s_reinit_requested &&
            s_applied_policy != CFG_CAM_POLICY_OFF && s_state != CAM_OFF) {
            s_reinit_requested = false;
            s_stop_stream = true;
            s_init_requested = true;
            action = ACT_DEINIT;
            idle_to_off = false;
        }

        if (action == ACT_NONE && s_init_requested &&
            s_applied_policy != CFG_CAM_POLICY_OFF &&
            (s_state == CAM_IDLE || s_state == CAM_FAIL || s_state == CAM_OFF)) {
            s_init_requested = false;
            s_state = CAM_INIT;
            init_res = s_applied_res;
            init_quality = s_applied_quality;
            action = ACT_INIT;
        }

        if (action == ACT_NONE && s_state == CAM_ON &&
            s_applied_policy == CFG_CAM_POLICY_ON_DEMAND) {
            if (deadline_due(now, s_preview_deadline)) {
                ESP_LOGI(TAG, "preview hold expired, stop stream and camera");
                s_preview_deadline = CAM_DEADLINE_NONE;
                s_grace_deadline = CAM_DEADLINE_NONE;
                s_stop_stream = true;
                action = ACT_DEINIT;
                idle_to_off = false;
            } else if (deadline_due(now, s_grace_deadline) && !s_stream_active) {
                ESP_LOGI(TAG, "stream grace expired, stop camera");
                s_grace_deadline = CAM_DEADLINE_NONE;
                action = ACT_DEINIT;
                idle_to_off = false;
            }
        }

        if (action == ACT_NONE && !s_calib_active && s_state == CAM_ON &&
            s_fps_calibrated && s_sensor_fps_ok) {
            uint32_t eff = cam_rate_effective(&s_rate);
            /* base 观测更新后，即使目标没变也要重算分频/VTS。 */
            if (eff != s_sensor_fps_applied || s_base_dirty) {
                fps_to_apply = eff;
                s_sensor_fps_applied = eff; /* 失败时下面的分支会关掉传感器控制 */
                s_base_dirty = false;
                action = ACT_SET_FPS;
            }
        }

        if (action == ACT_NONE && s_state == CAM_ON) {
            /* 传感器不支持寄存器控速时，用取帧节奏兜底：不取帧就不会把
             * JPEG 拷进 DMA/发布缓冲。支持控速时交给传感器自己降。 */
            if (!s_sensor_fps_ok && s_next_grab_ms != 0 &&
                (int32_t)(now - s_next_grab_ms) < 0) {
                /* 还没到下一拍，走底部的空闲延时 */
            } else {
                action = ACT_GRAB;
            }
        }

        unlock();

        if (quality_to_apply != 0) {
            if (camera_drv_set_quality(quality_to_apply) != ESP_OK) {
                lock();
                s_quality_fail_count++;
                if (s_quality_auto_ok && s_quality_fail_count >= CAM_QUALITY_FAIL_LIMIT) {
                    /* 连续失败说明这条链路有问题，关掉自适应并尝试把用户值
                     * 写回去一次；再失败也不再自动重试。 */
                    s_quality_auto_ok = false;
                    cam_quality_restore(&s_quality);
                    s_quality_pending = s_quality.effective != s_quality.applied;
                    s_quality_fail_count = 0;
                } else {
                    /* 普通失败等下一个 5 秒评估窗口再试，不在这里空转。 */
                    s_quality_pending = false;
                }
                unlock();
            } else {
                /* 写寄存器不持锁；这期间用户改配置或断流可能把目标值改了，
                 * 发现不一致就再排一次，让下一轮写新值。 */
                lock();
                s_quality.applied = (uint8_t)quality_to_apply;
                s_quality_fail_count = 0;
                if (s_quality.effective != quality_to_apply) {
                    s_quality_pending = true;
                }
                unlock();
            }
        }

        switch (action) {
        case ACT_DEINIT:
            (void)camera_drv_deinit();
            reset_calib_state();
            lock();
            set_idle_locked(idle_to_off ? CAM_OFF : CAM_IDLE);
            cam_rate_stream_stop(&s_rate, now_ms());
            /* 新的相机会话（下一次 init）从用户上限重新起步，校准后再夹到 base。 */
            apply_rate_cap_locked();
            reset_quality_state((uint8_t)s_applied_quality);
            if (idle_to_off) {
                ESP_LOGI(TAG, "camera off");
            } else {
                ESP_LOGI(TAG, "camera idle");
            }
            unlock();
            break;

        case ACT_SET_FPS: {
            esp_err_t e = camera_drv_set_fps(s_base_fps, fps_to_apply);
            if (e != ESP_OK) {
                ESP_LOGW(TAG, "sensor fps %lu failed (%d), fall back to grab pacing",
                         (unsigned long)fps_to_apply, e);
                s_sensor_fps_ok = false;
                s_next_grab_ms = 0;
            } else {
                /* 目标高于 base 时驱动保持基准，日志如实写实际生效值。 */
                uint32_t applied = (fps_to_apply < s_base_fps) ? fps_to_apply : s_base_fps;
                ESP_LOGI(TAG, "sensor fps: request %lu, effective %lu (base %lu)",
                         (unsigned long)fps_to_apply, (unsigned long)applied,
                         (unsigned long)s_base_fps);
            }
            break;
        }

        case ACT_INIT: {
            bool ok = false;
            camera_drv_cfg_t dcfg = {
                .res = init_res,
                .quality = init_quality,
            };

            lock();
            bool alloc_ok = alloc_pub_locked(init_res);
            unlock();

            if (alloc_ok) {
                esp_err_t e = camera_drv_init(&dcfg);
                if (e == ESP_OK) {
                    ok = true;
                } else {
                    ESP_LOGE(TAG, "camera init failed: %d", e);
                }
            }

            lock();
            if (ok) {
                uint32_t ready_ms = now_ms();
                s_state = CAM_ON;
                s_fail_count = 0;
                s_fps_window_ms = ready_ms;
                s_fps_frames = 0;
                s_last_frame_ms = 0;
                /* 新会话从用户配置的画质起步，自适应重新开始。 */
                reset_quality_state((uint8_t)init_quality);
                s_init_requested = false; /* 本次 init 已满足发起它的请求 */
                reset_calib_state();
                s_sensor_fps_ok = camera_drv_fps_control_supported();
                if (!s_sensor_fps_ok) {
                    ESP_LOGW(TAG, "sensor fps control unsupported, use grab pacing");
                }
                if (s_applied_policy == CFG_CAM_POLICY_ON_DEMAND) {
                    if (!s_preview_active && s_preview_deadline == CAM_DEADLINE_NONE) {
                        s_preview_deadline = ready_ms + CAM_PREVIEW_HOLD_MS;
                    } else if (s_preview_active && !s_stream_active &&
                               s_grace_deadline == CAM_DEADLINE_NONE) {
                        s_grace_deadline = ready_ms + CAM_STREAM_GRACE_MS;
                    }
                } else {
                    s_preview_deadline = CAM_DEADLINE_NONE;
                    s_grace_deadline = CAM_DEADLINE_NONE;
                }
                ESP_LOGI(TAG, "camera on: %s, q=%lu, target=%lufps",
                         res_str(init_res), (unsigned long)init_quality,
                         (unsigned long)cam_rate_effective(&s_rate));
            } else {
                free_pub_locked();
                s_state = CAM_FAIL;
                s_fail_count = 0;
                s_stop_stream = true;
                s_init_requested = false;
                s_preview_deadline = CAM_DEADLINE_NONE;
                s_grace_deadline = CAM_DEADLINE_NONE;
                reset_calib_state();
                ESP_LOGE(TAG, "camera state=fail; next stream/snapshot retries");
            }
            unlock();
            break;
        }

        case ACT_GRAB: {
            esp_err_t e = camera_drv_grab(&frame);
            if (e == ESP_OK) {
                /* 取帧会阻塞，时间戳按拿到帧的时刻算，不能用循环开头的 now。 */
                uint32_t grab_ms = now_ms();
                publish_frame(&frame, grab_ms);
                camera_drv_release(&frame);
                calibrate_sensor_fps(grab_ms);
                pace_next_grab();
            } else {
                bool fail_now = false;
                lock();
                s_fail_count++;
                if (s_fail_count >= CAM_FAIL_LIMIT) {
                    fail_now = true;
                }
                unlock();
                if (fail_now) {
                    ESP_LOGE(TAG, "frame grab failed %lu times, camera state=fail",
                             (unsigned long)CAM_FAIL_LIMIT);
                    (void)camera_drv_deinit();
                    lock();
                    s_state = CAM_FAIL;
                    s_stop_stream = true;
                    s_init_requested = false;
                    free_pub_locked();
                    s_preview_deadline = CAM_DEADLINE_NONE;
                    s_grace_deadline = CAM_DEADLINE_NONE;
                    cam_rate_stream_stop(&s_rate, now_ms());
                    unlock();
                    reset_calib_state();
                }
            }
            break;
        }

        case ACT_NONE:
        default:
            vTaskDelay(pdMS_TO_TICKS(CAM_IDLE_POLL_MS));
            break;
        }
    }
}

esp_err_t bench_cam_start(cfg_params_t *cfg, SemaphoreHandle_t cfg_mutex)
{
    if (cfg == NULL || cfg_mutex == NULL) {
        return ESP_ERR_INVALID_ARG;
    }
    s_cfg = cfg;
    s_cfg_mutex = cfg_mutex;
    s_lock = xSemaphoreCreateMutex();
    if (s_lock == NULL) {
        return ESP_ERR_NO_MEM;
    }

    s_applied_policy = cfg->cam_policy;
    s_applied_res = cfg->cam_res;
    s_applied_quality = cfg->cam_quality;
    reset_quality_state((uint8_t)cfg->cam_quality);
    s_user_fps_cap = cfg->cam_fps_cap;
    cam_rate_init(&s_rate, cfg->cam_fps_cap);
    s_cached_overlay = cfg->overlay_mask;
    s_state = (cfg->cam_policy == CFG_CAM_POLICY_OFF) ? CAM_OFF : CAM_IDLE;
    s_init_requested = (cfg->cam_policy == CFG_CAM_POLICY_ALWAYS);

    BaseType_t ok = xTaskCreatePinnedToCore(cam_task, "cam_publish", WHEEL_CAM_PUB_STACK,
                                            NULL, WHEEL_CAM_PUB_PRIO, NULL,
                                            WHEEL_CAM_PUB_CORE);
    if (ok != pdPASS) {
        vSemaphoreDelete(s_lock);
        s_lock = NULL;
        return ESP_ERR_NO_MEM;
    }
    ESP_LOGI(TAG, "camera service started: policy=%s res=%s q=%lu fps_cap=%lu",
             policy_str(s_applied_policy), res_str(s_applied_res),
             (unsigned long)s_applied_quality, (unsigned long)cam_rate_cap(&s_rate));
    return ESP_OK;
}

bench_cam_stream_result_t bench_cam_stream_acquire(void)
{
    if (s_lock == NULL) {
        return BENCH_CAM_STREAM_BUSY;
    }
    if (xSemaphoreTake(s_lock, pdMS_TO_TICKS(200)) != pdTRUE) {
        return BENCH_CAM_STREAM_BUSY;
    }

    bench_cam_stream_result_t result = BENCH_CAM_STREAM_OK;
    if (s_applied_policy == CFG_CAM_POLICY_OFF) {
        result = BENCH_CAM_STREAM_OFF;
    } else if (s_ota_suspend) {
        /* 升级中相机正在 deinit，新的流请求不能把它拉起来 */
        result = BENCH_CAM_STREAM_BUSY;
    } else if (s_stream_active) {
        result = BENCH_CAM_STREAM_BUSY;
    } else {
        s_stream_active = true;
        s_stop_stream = false;
        s_preview_active = true;
        s_preview_deadline = CAM_DEADLINE_NONE;
        s_grace_deadline = CAM_DEADLINE_NONE;
        cam_rate_stream_start(&s_rate, now_ms());
        if (s_state != CAM_ON) {
            s_init_requested = true;
        }
    }
    xSemaphoreGive(s_lock);
    return result;
}

void bench_cam_stream_release(void)
{
    if (s_lock == NULL) {
        return;
    }
    lock();
    if (!s_stream_active) {
        unlock();
        return;
    }
    s_stream_active = false;
    /* 断流后保留降速结果：网络可能还没恢复，下一次请求先按低帧率起步，
     * 由 cam_rate 的 recovery 慢慢升回去；相机 deinit 时才恢复用户上限。
     * always 没有流时不存在网络压力，直接回到当前上限。 */
    cam_rate_stream_stop(&s_rate, now_ms());
    /* 断流后预览没有网络压力，把自适应压低的画质还给用户配置；
     * 实际寄存器写入由 cam_task 做。 */
    if (cam_quality_restore(&s_quality)) {
        s_quality_pending = true;
    }
    if (s_applied_policy == CFG_CAM_POLICY_ALWAYS) {
        apply_rate_cap_locked();
    }
    if (s_applied_policy == CFG_CAM_POLICY_ON_DEMAND && s_state == CAM_ON) {
        s_grace_deadline = now_ms() + CAM_STREAM_GRACE_MS;
    }
    unlock();
}

void bench_cam_report_send_time(uint32_t send_ms)
{
    if (s_lock == NULL) {
        return;
    }
    lock();
    uint32_t before = cam_rate_effective(&s_rate);
    uint32_t after = cam_rate_report_send(&s_rate, send_ms, now_ms());
    if (after < before) {
        ESP_LOGW(TAG, "network throttle: %lu -> %lu fps (avg_send %lu ms)",
                 (unsigned long)before, (unsigned long)after,
                 (unsigned long)s_rate.last_avg_ms);
    } else if (after > before) {
        ESP_LOGI(TAG, "network recovered: %lu -> %lu fps (avg_send %lu ms)",
                 (unsigned long)before, (unsigned long)after,
                 (unsigned long)s_rate.last_avg_ms);
    }
    unlock();
}

bool bench_cam_stream_should_stop(void)
{
    if (s_lock == NULL) {
        return true;
    }
    if (xSemaphoreTake(s_lock, pdMS_TO_TICKS(100)) != pdTRUE) {
        return false;
    }
    bool stop = s_stop_stream;
    xSemaphoreGive(s_lock);
    return stop;
}

void bench_cam_set_frame_wait_task(TaskHandle_t task)
{
    s_frame_wait_task = task;
}

esp_err_t bench_cam_copy_latest(uint8_t *dst, size_t cap, size_t *len, uint32_t *gen)
{
    if (dst == NULL || len == NULL) {
        return ESP_ERR_INVALID_ARG;
    }
    if (s_lock == NULL) {
        return ESP_ERR_INVALID_STATE;
    }
    if (xSemaphoreTake(s_lock, pdMS_TO_TICKS(200)) != pdTRUE) {
        return ESP_ERR_TIMEOUT;
    }
    esp_err_t e = ESP_OK;
    if (s_frame_len == 0 || s_pub == NULL ||
        (gen != NULL && *gen == s_frame_gen)) {
        /* gen 相同说明没有新帧：不要每次轮询都白拷一份几十 KB 的 JPEG。 */
        e = ESP_ERR_NOT_FOUND;
    } else if (s_frame_len > cap) {
        e = ESP_ERR_INVALID_SIZE;
    } else {
        memcpy(dst, s_pub, s_frame_len);
        *len = s_frame_len;
        if (gen != NULL) {
            *gen = s_frame_gen;
        }
    }
    xSemaphoreGive(s_lock);
    return e;
}

size_t bench_cam_max_frame(void)
{
    if (s_lock == NULL) {
        return camera_drv_max_jpeg(CFG_CAM_RES_SVGA);
    }
    lock();
    size_t cap = s_pub_cap != 0 ? s_pub_cap : camera_drv_max_jpeg(s_applied_res);
    unlock();
    return cap;
}

bench_cam_snap_result_t bench_cam_snapshot(uint8_t **out, size_t *len)
{
    if (out == NULL || len == NULL || s_lock == NULL) {
        return BENCH_CAM_SNAP_NO_MEM;
    }
    *out = NULL;
    *len = 0;

    if (xSemaphoreTake(s_lock, pdMS_TO_TICKS(200)) != pdTRUE) {
        return BENCH_CAM_SNAP_WARMING;
    }

    if (s_applied_policy == CFG_CAM_POLICY_OFF) {
        xSemaphoreGive(s_lock);
        return BENCH_CAM_SNAP_OFF;
    }

    if (s_ota_suspend) {
        /* 升级中不启动相机，也不接受新快照 */
        xSemaphoreGive(s_lock);
        return BENCH_CAM_SNAP_WARMING;
    }

    if (s_state != CAM_ON) {
        bench_cam_snap_result_t r = (s_state == CAM_FAIL) ? BENCH_CAM_SNAP_FAIL
                                                          : BENCH_CAM_SNAP_WARMING;
        s_init_requested = true;
        xSemaphoreGive(s_lock);
        return r;
    }

    if (s_frame_len == 0 || s_pub == NULL) {
        /* 已经 on 但第一帧还没出来：也算快照消费者在场，起 30 秒宽限，
         * 免得页面刚请求完就关掉、相机没人管一直开着。 */
        if (s_applied_policy == CFG_CAM_POLICY_ON_DEMAND && !s_stream_active) {
            s_grace_deadline = now_ms() + CAM_STREAM_GRACE_MS;
        }
        xSemaphoreGive(s_lock);
        return BENCH_CAM_SNAP_WARMING;
    }

    /* 快照罕见，拷贝缓冲按当前帧长分配；成功即证明消费者在场，起 30 秒宽限。 */
    uint8_t *p = heap_caps_malloc(s_frame_len, MALLOC_CAP_SPIRAM | MALLOC_CAP_8BIT);
    if (p == NULL) {
        xSemaphoreGive(s_lock);
        return BENCH_CAM_SNAP_NO_MEM;
    }
    memcpy(p, s_pub, s_frame_len);
    *len = s_frame_len;
    if (s_applied_policy == CFG_CAM_POLICY_ON_DEMAND && !s_stream_active) {
        s_grace_deadline = now_ms() + CAM_STREAM_GRACE_MS;
    }
    xSemaphoreGive(s_lock);
    *out = p;
    return BENCH_CAM_SNAP_OK;
}

void bench_cam_set_preview(bool active)
{
    if (s_lock == NULL) {
        return;
    }
    lock();
    if (s_preview_active == active) {
        /* 重复的 active=false 不重置计时；active=true 的重复也无事可做。 */
        unlock();
        return;
    }
    s_preview_active = active;
    if (active) {
        s_preview_deadline = CAM_DEADLINE_NONE;
        s_grace_deadline = CAM_DEADLINE_NONE;
    } else if (s_applied_policy == CFG_CAM_POLICY_ON_DEMAND &&
               (s_state == CAM_ON || s_state == CAM_INIT)) {
        s_preview_deadline = now_ms() + CAM_PREVIEW_HOLD_MS;
    }
    unlock();
}

void bench_cam_on_ws_disconnect(void)
{
    bench_cam_set_preview(false);
}

void bench_cam_suspend_for_ota(void)
{
    if (s_lock == NULL) {
        return;
    }
    lock();
    s_ota_suspend = true;
    s_stop_stream = true;
    s_init_requested = false;
    s_reinit_requested = false;
    unlock();

    /* cam_task 空闲轮询 20ms；用墙钟卡总时长，锁竞争时不会无限延长。 */
    int64_t started = esp_timer_get_time();
    while (esp_timer_get_time() - started < 2000000) {
        if (bench_cam_state() == BENCH_CAM_STATE_OFF) {
            return;
        }
        vTaskDelay(pdMS_TO_TICKS(20));
    }
    ESP_LOGW(TAG, "camera still busy after 2s, OTA continues");
}

void bench_cam_resume_after_ota(void)
{
    if (s_lock == NULL) {
        return;
    }
    lock();
    s_ota_suspend = false;
    if ((s_applied_policy == CFG_CAM_POLICY_ALWAYS ||
         (s_applied_policy == CFG_CAM_POLICY_ON_DEMAND && s_preview_active)) &&
        s_state != CAM_ON) {
        s_init_requested = true;
    } else if (s_applied_policy == CFG_CAM_POLICY_ON_DEMAND && s_state == CAM_OFF) {
        s_state = CAM_IDLE;
    } else if (s_applied_policy == CFG_CAM_POLICY_ON_DEMAND && s_state == CAM_ON &&
               !s_stream_active && !s_preview_active &&
               s_preview_deadline == CAM_DEADLINE_NONE) {
        /* 挂起等待超时、相机没来得及停：补保持截止时间，别让它一直开着。 */
        s_preview_deadline = now_ms() + CAM_PREVIEW_HOLD_MS;
    }
    unlock();
}

void bench_cam_get_status(telem_cam_status_t *out)
{
    if (out == NULL) {
        return;
    }
    memset(out, 0, sizeof(*out));
    if (s_lock == NULL) {
        out->policy = "off";
        out->state = "off";
        out->res = "qvga";
        return;
    }

    lock();
    uint32_t now = now_ms();
    out->policy = policy_str(s_applied_policy);
    out->state = state_str(s_state);
    out->preview_active = s_preview_active;
    out->streaming = s_stream_active;
    out->clients = s_stream_active ? 1 : 0;
    out->res = res_str(s_applied_res);
    out->quality = (uint8_t)s_applied_quality;
    out->quality_eff = s_quality.applied;
    out->fps_cap = (uint8_t)cam_rate_cap(&s_rate);
    out->fps_user_cap = (uint8_t)s_user_fps_cap;
    out->fps_eff = (uint8_t)cam_rate_effective(&s_rate);
    out->overlay_mask = s_cached_overlay;
    out->bytes = (uint32_t)s_frame_len;

    if (s_last_frame_ms != 0 && now - s_last_frame_ms > 2000) {
        out->fps = 0.0f;
    } else {
        out->fps = s_fps;
    }

    if (s_applied_policy == CFG_CAM_POLICY_ON_DEMAND &&
        (s_state == CAM_ON || s_state == CAM_INIT)) {
        bool have = false;
        uint32_t best = 0;
        uint32_t deadlines[2] = {s_preview_deadline, s_grace_deadline};
        for (int i = 0; i < 2; i++) {
            if (deadlines[i] == CAM_DEADLINE_NONE) {
                continue;
            }
            int32_t rem = (int32_t)(deadlines[i] - now);
            if (rem < 0) {
                rem = 0;
            }
            uint32_t sec = ((uint32_t)rem + 999u) / 1000u;
            if (!have || sec < best) {
                best = sec;
                have = true;
            }
        }
        out->stop_in_s = have ? best : 0;
    }
    unlock();
}

bench_cam_state_t bench_cam_state(void)
{
    if (s_lock == NULL) {
        return BENCH_CAM_STATE_OFF;
    }
    if (xSemaphoreTake(s_lock, pdMS_TO_TICKS(100)) != pdTRUE) {
        return BENCH_CAM_STATE_INIT;
    }
    cam_state_t st = s_state;
    xSemaphoreGive(s_lock);
    switch (st) {
    case CAM_OFF:
        return BENCH_CAM_STATE_OFF;
    case CAM_IDLE:
        return BENCH_CAM_STATE_IDLE;
    case CAM_ON:
        return BENCH_CAM_STATE_ON;
    case CAM_FAIL:
        return BENCH_CAM_STATE_FAIL;
    case CAM_INIT:
    default:
        return BENCH_CAM_STATE_INIT;
    }
}
