Yin-bo-de/wheel_speed_monitor/main/config_store.h

/*
 * config_store：NVS 薄封装（namespace wheelcfg）。
 * load：无记录 → 默认值并回写；save：冗余写 blob。仅 httpd 上下文调用
 * （不阻塞计算链）。
 */
#ifndef CONFIG_STORE_H
#define CONFIG_STORE_H

#include "config_params.h"

#ifdef __cplusplus
extern "C" {
#endif

esp_err_t config_store_load(cfg_params_t *out);
esp_err_t config_store_save(const cfg_params_t *cfg);

#ifdef __cplusplus
}
#endif

#endif /* CONFIG_STORE_H */
