Yin-bo-de/wheel_speed_monitor/(commit log)

2026-09-06 feat: 四轮转速监测验证台 v1（TDD 完成）
    - telemetry 采集框架：注册表/采样泵/JSON 帧聚合，纯 C 宿主机可测
    - wheel_speed 采集器：数学链/16 位回绕判定/模拟源/JSON 渲染
    - wheel_sensor：PCNT 4 单元薄封装
    - strategy：二期差速策略接口桩（PWM 输入/舵机输出预留）
    - Web 验证台：WiFi AP + 内嵌页面（仪表盘/曲线/IO 监视/模拟模式/配置）
    - 宿主机单测 8 套件 55 用例全绿；idf.py build 通过
2026-09-06 fix: 启动稳定性修复（烧录实测发现）
    - config_store: nvs_open 首次 NOT_FOUND（namespace 不存在）导致 abort；
    补处理：默认值并回写
    - wheel_sensor: memcpy 把 uint8_t[4] 拷贝进 int[4] 只复制 4 字节，
    后 12 字节未初始化→gpio 越界→LoadProhibited；改逐个赋值
    - wifi_ap: create_default_wifi_ap 已内置 DHCP 192.168.4.1，
    手动 set_ip_info 因 DHCP 已启动返回 INVALID_STATE 导致重启循环；删除
    - ws_push_task: 栈 4096 溢出（2048 帧缓冲+snprintf/WS/WiFi 调用面）→ 8192
    验证：连续 8s+3s 窗口 0 reboot / 0 stack overflow / 0 panic
    [bench_http_server.c, config_store.c, wheel_bench_main.c, wheel_config.h, wheel_sensor.c]
2026-09-06 feat: 引入脉冲间隔测频法，修复 WS 生命周期与渲染槽位 bug
    - 新增 wsmath_update_period / wheel_chan_sample_period：基于两次脉冲
    间隔实时计算频率/RPM，避免窗口法在单脉冲时倍频误报
    - wheel_sensor 增加 ISR 测周期 + 有效计数（去抖），暴露 get_period_us
    / get_valid_count，避免 PCNT 原始计数被磁铁贴近抖动污染
    - 修复 ws_handler：握手帧（HTTP_GET）注册 fd，数据帧才解析命令，
    与官方 ws_echo_server 生命周期一致；此前在数据帧末尾注册 fd 错时
    - 修复 ws_push_task 渲染槽位：统一写 s_units[0].disp.wheels[i]，
    此前误写各 unit 自己的 wheels[i] 导致 wheels[1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
    [bench_http_server.c, telemetry.c, test_collector.c, test_math.c, test_render.c, wheel_bench_main.c, wheel_sensor.c]
2026-09-09 refactor(wheel_speed): 移除窗口法，仅保留脉冲间隔测频
    删除 wheel_speed_math 的 wsmath_update（窗口计数法）与 STATIC_IDLE_TIMEOUT，
    频率/RPM/EMA 统一由 wsmath_update_period（间隔法）维护。
    wheel_speed_collector:
    - 删除 use_period 开关，wheel_chan_sample 仅做累计脉冲/回绕/去抖/trigger
    + 2s 静止归零兜底（间隔法无脉冲时不被调用，需本层主动清零）
    - 有脉冲时刷新 math.last_pulse_ms 供静止判定使用
    sim_source:
    - 新增虚拟时间 vtime_us 与 last_pulse_vtime，emit 脉冲时记录跨窗口间隔，
    低速跨多窗口才出一个脉冲也能如实反映真实周期
    - 新增 sim_source_period_us()，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
2026-09-11 feat(strategy): 差速策略引擎重写，桩换成三态锁定状态机
    strategy 从接口桩（全部 ESP_ERR_NOT_SUPPORTED）重写为真实引擎，新增
    servo_act 执行器抽象，两者都是纯 C 组件、宿主机可测。
    打滑判定为什么不是"比例低于阈值就解锁"：
    锁差速这个动作本身会把该轴左右轮速差抹平（两轮被强制同步），于是
    "比例低于阈值"在锁定后必然成立、必然松开；松开后打滑重现又必然锁回，
    形成稳定振荡。被控制动作污染的信号不能拿来做控制判断。
    每轴一个三态状态机：
    - IDLE 解锁，盯左右速差比例，超门槛即锁，保持时长取初始值
    - LOCKE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
2026-09-11 feat(config): 配置 blob 升 v2（舵机与锁定策略参数），支持 v1 迁移
    blob 由 32 字节扩到 72 字节，版本号升 2，尾部补零。v1 段布局原样保留，
    v2 新增段放舵机与锁定策略参数：模拟开关、双通道使能/反向、脉宽三元组、
    手动目标、打滑进入门槛、最低判定转速、初始保持/保持上限/试探窗口、
    模拟行程速率。
    迁移：cfg_params_unpack 先铺默认值再按首字节版本号分派——v1 blob 只解
    v1 段，新字段落默认值；v2 全解；其余版本拒绝。config_store_load 解出 v1
    后立刻回写 v2，之后 NVS 恒为最新布局，不必每次上电都迁移。
    校验新增跨字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
2026-09-11 feat(bench): 采样任务集成舵机控制链，页面 tab 化并新增设置页
    控制链挂在现有 sampler_task 里同一节拍推进，不新增任务：
    四轮 rpm_ema → strategy（状态机算目标脉宽）→ 舵机执行器 → 填渲染快照。
    被禁用的轮子喂 0 而不是残留值，避免拿陈旧转速判打滑。
    telemetry：
    - telem_type_t 新增 TELEM_TYPE_SERVO，走 README 定的采集器扩展四步
    - ops 的 sample 允许为 NULL：状态由采样任务的控制路径推进的采集器
    不必让框架再推一次
    - servo 块带 phase 字段（idle/locked/probe）——锁定期间轮速差被自己的
    动作抹平，光看数值看不出状态机在做什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
2026-09-11 docs: CLAUDE.md 补新增模块的架构原则；清理死配置与陈旧测试期望
    CLAUDE.md「代码组织纪律」改写为原则先行：新增模块（采集器、驱动、配置项、
    任务）必须先对齐现有分层，偏离需写明理由。逐条列出纯算的分层、新数据走
    telemetry 采集器框架、新配置进 cfg_params 且 NVS 只经 config_store、
    不轻易加任务、构建与测试清单显式。
    sdkconfig.defaults：删掉两项空转配置。CONFIG_ESP_WIFI_AP_MAX_STA_CONN 与
    CONFIG_HTTPD_STACK_SIZE 在 IDF 5.5 里都不存在，写了等于没写（实际值由代码
    运行时设置），留着会误导。原地注明真实设置位置。
    .gitignore：d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
2026-09-12 fix：ctx、空指针保护、断开与收帧失败日志）
2026-09-13 feat(servo_drv): LEDC 硬件输出层，模拟轮速可直接驱动真实舵机
    新增 components/servo_drv：50Hz / 14 位 LEDC，前差速 GPIO41、后差速 GPIO42，
    实现 servo_act_ops_t 接口，与 servo_sim 在运行时切换。到这里"验证台模拟轮速
    喂进策略、策略驱动真舵机"这条链就通了——sim_on 与 servo_sim 两个开关互相独立，
    模拟轮速 + 真实舵机正是要验的组合。
    执行器切换（servo_act_select）刻意放在采样任务里，不挂在 httpd 的配置回调上：
    LEDC 的初始化与全部寄存器写就都落在同一个任务上下文，httpd 只改配置数据、
    永不碰硬件句柄，省掉跨核初始化窗口和一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
2026-09-21 feat(config): 差速舵机脉宽改两档式，前后轴各自配置（blob 升 v3）
    自动模式的脉宽映射从共享的 min/center/max 连续量程，换成每通道两个落点：
    解锁档与锁定档各一个数，前后轴各配一组。差速器只有锁止和释放两个确定位置，
    中间行程对机械没有意义，连续映射只是把一件两值的事说复杂了。手动模式不变，
    仍然直通它自己的目标脉宽。
    方向不再需要「反向」开关。旧设计靠 invert 决定锁定去 min 还是 max 那一端，
    现在锁定档本身就是个脉宽，装反的舵机把该轴这两档填到行程另一端即可。
    脉宽↔角度那对函数和页面上的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
    [bench_http_server.c, config_params.c, config_params.h, servo_act.h, servo_drv.h, servo_sim.c, strategy.c, strategy.h]
2026-10-07 feat(rc_input): 遥控通道判定与仲裁，纯 C 模型
    三路通道（模式/前差速/后差速）各存"最近一次脉宽 + 收到时刻"，有效性 =
    收到过、且距今不超过超时。模式通道 ≥1500µs 判手动、<1500µs 判自动；
    手动模式下前后差速通道的脉宽原样透传，各轴无效时回落设置页的手动目标
    滑杆值，模式通道无效时模式回落设置页的自动/手动配置。
    模式判定与差速透传刻意各自独立判定：每根线单独断都有确定行为，不必
    约定"三根线都有效才认遥控"这种更脆弱的前提。车上最常发生的故障就是
    某根信号线松掉，独立判定让那一路单独回落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
2026-10-07 feat(rc_render): 遥控输入遥测块（JSON）
    输出 {"type":"rc",...}：三路通道的脉宽/有效性/年龄、每轴生效目标及其来源
    （遥控透传 or 回落滑杆）、生效模式及其来源（遥控 or 设置），外加模拟开关
    与三路模拟值的配置回显。
    seen 与 valid 分开报，是为了区分"从未收到"（线没接）和"超时"（掉线了）——
    这两种情况在调试时指向完全不同的动作，页面混成一个"无信号"会白跑一趟。
    每轴目标带上 from_rc 标记：这套功能唯一要验的就是"这根轴此刻听谁的"，
    不能只报一个脉宽让看的人去猜。
    空指针兜底成默认值而不是报错：纯展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
2026-10-07 feat(config): 遥控输入进配置模型，blob 升 v4（旧配置无损迁移）
    新增两个字段：rc_sim（遥控模拟开关）与 rc_sim_us[3]（模式/前差速/后差速三路
    模拟脉宽），量程与舵机脉宽一致（500~2500µs）——模拟值最终要不经换算地喂进
    rc_input，两边共用同一条边界，不另设一套。
    blob 76B → 84B：v4 段追加在 v3 段之后（[76] rc_sim、[77..82] rc_sim_us、
    [83] 保留），v1 与 v3 两段的偏移一个字节都没动，旧固件写下的 blob 逐字节
    可解。解包按版本号分派：1/2/3 各走原路径，新字段取默认值后由上层回写；
    新增 v3 fixture（76B 手工字节流，不复用打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
2026-10-07 feat(render): servo 块报生效模式与来源，删掉恒失败的 rc 桩
    顶层 mode 字段改由 effective_mode 渲染，并新增 mode_src（rc/cfg）。原先是
    从 cfg.mode 算的——那在遥控接管后会撒谎：页面显示"自动"、舵机却在跟着
    遥控的脉宽走。cfg 段里的 mode 仍是配置值，设置页的自动/手动单选靠它回填，
    跟着遥控变会让表单自己跳。
    strategy_rc_read 与其测试断言一并删除。它是二期占位，恒返回
    NOT_SUPPORTED；现在判定与仲裁由 rc_input 承担，桩留着只会让人以为
    还有另一条读 RC 的路径。
    strategy 的状态机与映射逻辑不动：手动模式本来就是"直设脉宽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
2026-10-07 feat(rc_capture): GPIO 双沿中断捕获遥控脉宽
    上升沿记时刻、下降沿算差值写成脉宽。三路合计 300 次中断/秒，没信号时
    一次中断都没有——"有没有信号"天然由时间戳年龄给出，不需要额外的存活机制。
    引脚输入开内部下拉：接收机没上电时信号线悬空，不拉住就会乱跳，每个毛刺
    都记一次上升沿。悬空沿（没等到上升沿就来的下降沿）与宽度越界的脉冲在
    ISR 里丢掉，量程常量直接复用 rc_input 的 RC_US_MIN/MAX——边界值不在两处
    各写一遍。
    处理函数刻意不标 IRAM_ATTR：里面调了 gpio_get_level（在 flash 里），而 ISR
    服务是 gpio_inst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
2026-10-07 feat(main): 遥控链接进控制链，信号源模拟/真捕获可切
    采样节拍上多两步：rc_source_step 取脉宽（模拟注入或 GPIO 捕获）喂进 rc_input
    模型，rc_apply_resolved 把"RC 有信号用 RC、无效回落设置页配置"的结果覆盖到
    strategy 配置的模式与手动目标上。strategy 的状态机与映射一行没改——手动模式
    本来就是"直设脉宽、不跑状态机"，透传语义天然吻合。
    捕获的初始化与舵机执行器同规矩：惰性、在采样任务上下文里做（引脚配置与
    中断挂载同一个任务），httpd 只改配置数据。失败只记一次日志，不再每 50ms
    重试刷屏；此时三路通道按无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
2026-10-07 feat(bench): 页面加「遥控输入」监测卡与「遥控模拟」设置卡
    监测卡报三路通道的脉宽与状态：区分"从未收到"（线没接）和"无信号（430ms
    前）"（掉线了）——这两种情况调试时指向的动作完全不同，混成一个"无信号"
    会白跑一趟。模式通道另外标出落在自动区还是手动区；两根差速通道后面直接
    写"→ 透传 1800µs"或"→ 回落滑杆 1500µs"，一眼看出这根轴此刻听谁的。
    舵机卡的模式也带上来源：遥控接管时页面上的"自动/手动"是生效值，与设置页
    那一栏可能不同，不写出来就会让人以为设置没生效。
    设置卡是三个滑杆加一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
2026-10-07 fix(rc_capture): 别让重复安装 ISR 服务在启动日志里留一行假故障
    gpio_install_isr_service 对"已安装"只回一行 ESP_LOGE，日志里就多出一条
    看着像故障的 E 行。改成先直接挂 handler（wheel_sensor 早已装好服务，这一步
    会成功），只有真没装（本组件被单独使用）才补装一次。
    补一行"RC 捕获就绪 模式=GPIO38 前=39 后=40"：接线排查时先看这行，能一眼
    分清"捕获层没起来"和"起来了但没信号"。
    板级已验：启动日志干净（无 E 行、无栈溢出），rc 配置行与采集器注册正常。
2026-10-07 docs: 遥控输入进引脚表/任务表/组件职责图，README 补使用与验证步骤
    引脚表把"二期 RC 输入 未定"换成实到 GPIO38/39/40，并写清代价与取舍：
    这三根原是 SD 卡座的脚，让位后卡座不再可用；39/40 兼 JTAG 脚与 41/42 同理；
    没选 3/45/46 的理由（上电敏感）留在表里，免得以后有人问"为什么不用那三个
    净空脚"。
    README 补一节遥控输入：模式判定规则、丢失回落、验证台上四种现象怎么设、
    接真接收机时要注意什么（模拟开关要关掉、接收机 failsafe 行为先确认）。
    二期规划里删掉已实现的 RC 那条。
2026-10-08 fix(bench): 手动模式的锁定状态与速差方向标签都会撒谎
    两处都是显示层的问题，固件侧的字段语义其实是对的，是页面拿错了用法。
    一、手动模式下徽章恒显示"已解锁"。手动模式根本不跑状态机，phase 按设计
    恒为 idle——遥控把脉宽推到配置的锁定档（比如 2000µs）时，差速明明锁上了，
    徽章还写着"已解锁"。改成看指令脉宽落在哪一档：锁定档附近报"锁定位"、
    解锁档附近报"解锁位"、都不沾边报"手动"。给 20µs 容差，因为 RC 脉宽有
    几微秒抖动、舵机自身也有死区，按逐个微秒相等去判会来回跳。自动模式的
    三态徽章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
2026-10-10 feat(hw): 转接底板原理图 v3 + 生成工具链
    Freenove ESP32-S3 CAM 开发板的转接底板，从零到图纸全部脚本生成：
    - 电源：BEC 6~7.4V 进板，防反接后 5V 由 LM2596T-5.0 降压只供开发板，
    舵机/接收机/霍尔走 BEC 原电压；D2 防 USB 与底板互相倒灌
    - 信号：4 路霍尔（BEC 供电、3.3V 上拉、330R 红灯指示状态）、2 舵机、3 遥控
    - 扩展：J13/J14 把开发板 40 针 1:1 引出，J15 电源排针，将来用新脚不用重新打板
    - 工具：gen_schematic.py 生成 KiCad 9 格式图纸（10 可开），kicad_lib.py 解析
    官方符号库（含 extends 派生符号展开）；uuid5 派生保证重生成 diff 干净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
2026-10-10 feat(hw): PCB 布局布线完成，gerber 就绪
    96×122mm 双层板，40 个封装全部按真实外框摆放：
    - 布局：顶部霍尔接口+上拉/指示三行；排母下方 40 根 1:1 线帘；右侧接口列
    按 J2 目标针 x 递增排序（B 层五条走线不打结）；底部电源区
    - 布线：F.Cu 信号+电源（+BEC 主干 1.0~1.5mm），B.Cu 整板 GND 铺铜 + 跨板
    长走线；46 过孔；护栏式 DRC 迭代（tracks/clearance/shorting 逐条清零）
    - DRC 收尾：0 错误；余丝印级警告与一颗纯铜孤岛（README 已记录为接受项）
    - 导出：gerber + Excellon 钻孔已生成并打 zip（wheel_carrier-gerber.zip）
    - 坑已记 README：pcb drc 必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
2026-10-10 docs(hw): README 补两条 PCB 布局坑：封装原点在 pad1、同网汇合走线
2026-10-10 feat(hw): PCB 补全丝印：接口功能/GPIO、每针网名、电源脚极性
    板子此前只有位号与封装自带丝印，接线插板全靠翻 README，补齐：
    - 九个接口功能名+GPIO 号，3 针接口标注 S/+V/G；J15 四脚竖排词标、
    J12 端子下方 +/- 极性与输入电压；电源母线 +BEC/+3V3/+5V、指示灯用途
    - J1/J2/J13/J14 每一针网名错行排印，1 脚实心三角标，右端 J13=J1/J14=J2
    - 网名由网表生成（原理图改了 GPIO 分配会直接构建报错，不印过期号）；
    新增 check_silk() 几何自检：逐条文字对焊盘开窗/板边/彼此做包围盒检查
    - 顺带挪正 6 个压焊盘或邻件丝印的位号（LED1/LED6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
2026-10-11 feat(hw): v4 改版：2×8 电源条、电调/油门直通口，铺铜缝合与丝印电压标注
    - J15 从 1×4 扩成 2×8 电源条（BEC×2 / 5V×3 / 3V3×3，其余 8 针全 GND，
    每列「电源+地」相邻）——一根 2.54 针只插得下一根杜邦线，传感器多了
    原版 4 针不够分；丝印把每个电源脚的电压竖标在所在列正上方，下排两端标 GND
    - 新增 J16「电调 BEC 输入」与 J17「接收机·油门」：电调 3 针插头直接进板
    （三针中间必为 +V，插反不反电源），油门信号经板载纯铜直通走线到 J17
    再回接收机——板子不通电也照传；J12 螺丝端子保留，进电只允许一个来源
    -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
2026-10-12 fix(hw): 铺铜 min_thickness 修复地网断点；去掉 LED 链 A 网的重复走线
    - 未连接项目的根因修复：铺铜最小填充厚度沿用 KiCad 默认 0.254，密集区
    （电源条下方等窄缝）填不进去，整张 GND 网被悄悄撕成互不相通的两片
    （DRC 报「未连接项目」，断点还牵扯开发板地脚 J2.20/J14.20）。调到 0.2
    （≥ 设计规则下限）后整片连通，DRC 全零——丝印、连接、封装比对全部干净
    - 删掉 LED2~LED5 的 A 网重复走线：330R→LED 的同一段连接在最初版布线里
    写了两条路径（同网双线不属任何 DRC 错误类，一路静默留存），删去冗余
    的一条，每网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
2026-10-12 feat(hw): reload_kicad.py——用 KiCad IPC API 让打开中的图纸原地刷新
    改完图纸不用关 KiCad 重开：脚本连上正在运行的 KiCad（「设置 → 插件」里
    启用 API 后生效），对打开中的文档发 RevertDocument 命令，效果等价于菜单
    File → Revert。PCB 侧已实测可用；原理图侧 KiCad 10 的 API 还没实现
    （服务器回"没有处理器"），脚本优雅降级并提示手动 File → Revert。
    客户端库 kicad-python 装在 ~/.venvs/kicad-api，脚本未找到库时自动跳进
    该环境，用系统 python3 直接跑即可。README「改图纸的姿势」补用法与前提。
2026-10-13 fix(hw): 四个安装孔没进板文件，钻带里一把 2.7 的刀都没有
    - mounting_hole() 抄库封装时把 pad 节点跳过了，而 2.7mm 钻孔就挂在 pad
    上：钻带里没有这把刀（照文件做出来板子没有安装孔），铜也直接压着孔位
    走——左上角 +BEC 主干线原本从 (3.5,3.5) 孔心上横穿。你放大看板时发现
    "布线压着孔位"，顺着查出来的
    - 修复：保留 pad 节点；+BEC 顶干线第一跨绕孔（y=6.35 下穿、x=6.35 抬回，
    铜边距孔边 0.75）；check_silk() 把四个孔的开窗纳入自检（188 个开窗）
    - 实测：DRC 0 违规 / 0 未连接 / 0 封装错误；铺铜退到离孔心 1.605（环隙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
2026-10-13 fix(hw): J15 第 1 脚改圆盘——在 KiCad 里手工改的，同步回生成器
    - gen_pcb.py 的 embed_footprint 加一段 override：J15 1 脚 shape rect→circle，
    带断言（库盘形状若变化会直接报错，而不是按过期假设闷头生成）；脚序靠
    丝印的电压标注（最右列 BEC）仍然读得出
    - 闭环验证：重跑生成器 + 重填铺铜后，与手工版做语义对比（元件位置/焊盘/
    走线/过孔/丝印五类）差异为 0，证明脚本能复现手工版、重跑不再丢改动
    - 产物按流程重出：DRC 0/0，gerber/钻带（仍含 4×Ø2.7 安装孔）重导、
    压缩包重打、预览图重画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
2026-10-14 feat：增加kicad-syns更新原理图的skill
2026-10-14 feat(hw): v5 紧凑版——96×98.5，高度砍掉 19% 落进嘉立创免费档
    目标是进嘉立创 100×100 的免费打样档，办法是只压 y 轴、x 轴一米不动
    （宽度 96 本来就在档内），高度 122→98.5：
    - J13/J14 从 J2 下方 18/26mm 收到 5.08mm（压缩的最大一笔）。扇形引出
    重写为"半间距错位车道"：J1 列的线走 x−1.27、J2 列走 x+1.27，两组
    按时段借用同一条物理车道，J1 的线在 y=60.5 打孔下 B 层直接扎进 J13
    ——40 针全在 F 层解完，过孔还从 47 个减到 40 个
    - 右侧五路（舵机/遥控）改从 J14 的同网焊盘下方进入，不再穿 J13 行；
    霍尔四路改成"就近下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
2026-10-17 chore(hw): 清掉 v4 遗留的 DRC 排除项
    GUI 保存时把这些 lib_footprint_mismatch 旧排除项清空；当前工程设置已用忽略规则，DRC 0 违规。
2026-10-17 feat(hw): 4S 输入升级 C1/R5/D3，补使用说明书
    J12 端子可接 4S（≤16.8V）：C1 1000µF/25V、R5 1.5k、D3 SB560；原理图/PCB 器件值同步，封装和铜箔不变，接收机 +BEC 脚保持原样。
    4S 时靠接线手动断开接收机/舵机 +V；README BOM 同步，新增 hardware/使用说明书.md。
2026-10-28 feat(hw): v6 正面插装、舵机 5V、A3144 脚序，遥控三通道合并
    - 开发板改为正面插装：J1 接右排 IO43 列，J2 接左排 3V3 列，针 1 仍在左端
    - J7/J8 舵机 +V 改接板载 5V；J17 保持 BEC，接收机电源/地仍走 J17
    - 霍尔 J3~J6 改为 +V/GND/信号，匹配 A3144 1=VCC、2=GND、3=OUT
    - J10/J11 取消，遥控三通道合并为 J9 三针信号排针
    - C4 升级 1000µF/16V，加强 5V 舵机瞬态
    - 同步丝印、走线、脚序断言、README 与使用说明书；ERC/DRC 均 0/0
2026-10-28 fix(hw): J12 下移、取消左下角安装孔
    - J12 端子下移，本体底边离板底约 6mm，给底部接线留出操作空间
    - 取消左下角 M2.5 安装孔，安装孔从 4 个减到 3 个
    - 重排 J12 到 D1 的输入走线与底部丝印（+/-、BEC 电压标注移到端子下方）
    - README 补充 LED3 附近 B.Cu 空区的解释：GPIO1/GPIO14 横巷围成的孤立铜岛被 KiCad 删除
    ERC 0/0，DRC 0/0；Gerber/钻孔与正反面预览已重出。
2026-10-30 feat(cam): 增加按需 MJPEG 画面回传与浏览器叠加
    - 新增 camera_drv、bench_cam、bench_cam_stream：按需启停、单流、快照、30 秒保持/宽限
    - NVS v5 增加相机策略/分辨率/画质/帧率上限/叠加位图；telemetry 增加 sys.cam 与 heap_int
    - 页面增加画面卡、canvas 叠加、静态帧/翻转/快照，设置页增加相机配置
    - 开启 PSRAM 与 CAMERA_CORE1，钉 esp32-camera 2.1.8
    - 轮速基准只在轮速配置变化时重置，相机/叠加配置不再扰动采样
2026-10-31 feat(cam): 采集侧帧率控制与网络自适应降速
    - cam_fps_cap 改为采集/发送目标：OV2640 调 CLKRC、OV5640 拉长 VTS，实测基准后应用
    - 不支持寄存器控速的模组退回按目标节奏取帧
    - 新增 cam_rate 纯 C 控制器：按 MJPEG 发送阻塞自动降速，快速发送后逐步恢复
    - sys.cam 增加 fps_eff，页面状态行显示自动降速
    - 补 cam_rate 宿主机测试，全部 13 项通过
2026-10-31 feat(ui): 画面预览支持全屏查看
    - 画面卡增加全屏按钮，视频和 canvas 叠加层一起进入全屏
    - 容器内提供退出全屏按钮，支持 Esc 和切换 tab 自动退出
    - 不支持元素全屏的浏览器退化为固定定位铺满视口
    - fullscreenchange 后重算 canvas，叠加层保持对齐
2026-10-31 fix(cam): 停采后关闭 S3 XCLK，避免模组继续发热
    esp32-camera 在 ESP32-S3 上的 esp_camera_deinit() 只停采集和 DMA，
    不关 LCD_CAM 的时钟源；本板 PWDN 固定 -1，模组停采后仍收到 20MHz
    XCLK，持续成像发热。
    camera_drv_deinit() 现在显式把 cam_clk_sel 清 0，并把 GPIO15 改回
    普通 GPIO 拉低；初始化失败返回前也做同样收尾。重新 init 时
    ll_cam_config/ll_cam_set_pin 会恢复时钟与引脚路由，采集不受影响。
2026-10-31 fix(cam): OV5640 停采前进入软件掉电，降低待机发热
    关闭 XCLK 后 OV5640 仍保持常电偏置，停采 2 分钟散热片依然烫手。
    camera_drv_deinit() 现在先在 SCCB 还活着时写 SYSTEM_CTROL0(0x3008)
    的 bit6，让传感器进入软件掉电，等 5ms 再关 XCLK。
    下次 esp_camera_init() 会写 0x3008=0x82 清除掉电位，采集自动恢复。
    实测停采后出现 sensor standby、xclk off，模组温度明显下降。
2026-11-01 feat(ui): 预览画面支持四档手动旋转
    - 画面翻转勾选框改为左转/右转 90°，覆盖 0/90/180/270
    - 旋转只作用于视频，叠加层保持屏幕方向
    - 90°/270° 时容器改为竖向比例，全屏与静态帧同步重算
    - 角度存 localStorage，旧 wheelCamFlip 自动迁移为 180°
2026-11-06 fix：优化发帧取帧的逻辑，降低卡顿
2026-11-06 feat(ota): 双 OTA 分区表与版本号
    分区改为 ota_0/ota_1 各 4MB，预留 7.9MB storage；开启 bootloader
    回滚，新固件必须在 httpd 就绪后确认。PROJECT_VER 进镜像描述。
2026-11-06 feat(cam): OTA 期间挂起并恢复相机
    升级开始前停流、让发布任务 deinit 相机并等待最多 2 秒；升级失败
    后按原策略和预览状态恢复。
2026-11-06 feat(ota): 页面内固件上传、校验与回退
    新增三个端点：info 返回当前/另一分区版本与状态，upload 把固件顺序
    写入下一块 OTA 分区，rollback 切回另一分区。写入成功后延迟 2 秒重启，
    失败不切换启动分区并恢复相机。httpd 启动后标记固件有效，遥测在升级
    期间跳过广播。
2026-11-06 feat(ui): 设置页内嵌固件升级与回退
    新增升级卡片：展示当前/另一分区版本，浏览器预解析 ESP-IDF 镜像头，
    确认后 XHR 上传并显示进度，设备重启后轮询等待回来自动刷新。升级
    期间停预览并禁用卡片，失败恢复预览。
2026-11-06 docs(ota): 无线升级流程与模块说明
    README 补首次 USB 烧录、日常升级、版本号维护和救砖说明；CLAUDE.md
    补 bench_ota 模块、flash 写入期间的相机/遥测约束。
2026-11-06 fix(ota): 启动分区切换后始终重启
    响应因断网没送达时，原实现会留在旧固件继续跑，但 otadata 已经指向
    新分区，下次重启会意外换版本。改为切换成功即重启，页面靠轮询确认。
    前端补上 info 未就绪和另一客户端正在升级的提示。
2026-11-06 fix(ota): 扩 URI 槽位并加固升级边界
    httpd 默认 8 个 handler 槽位，页面/相机/OTA 共 9 个，第三个 OTA 路由
    注册失败会让设备启动即 abort。扩到 12。
    同时修复：回退只接受 valid 分区，避免把 aborted 镜像再切回去；上传加
    绝对超时，防慢速客户端长期占用 OTA 状态；相机挂起按墙钟计时并在超时
    恢复时补保持截止时间；前端以 running 等于目标分区判定成功，升级中
    暂停预览看门狗并恢复状态栏文字。
2026-11-06 docs(ota): 记录 httpd URI 槽位约束
    默认 8 个槽位不够当前 9 个端点，新增路由前必须先核对。
2026-11-06 feat(cam): 增加采集与发送帧率周期日志
    采集侧每 5 秒打印 grab/target/cap 和控速方式；发送侧每 5 秒打印
    send/grab/target、平均发送耗时和帧大小。两条日志时间窗口对齐，一眼
    区分是相机出帧慢还是网络发送慢。
2026-11-06 fix(cam): 采集帧率日志改用 5 秒窗口
    原来 grab 打印的是最近 1 秒平均、send 是 5 秒平均，口径不一致。采集
    侧改用独立 5 秒窗口，和发送侧同口径；发送日志里的采集体感值标成
    grab(1s)。相机停启时重置日志窗口，避免把空闲时间算进去。
2026-11-06 feat(cam): 帧率自适应改为启动保护和 1 秒窗口平均
    流启动前 5 秒不降速，避开 AEC 收敛和 TCP 建窗期的长尾；发送耗时
    按 1 秒窗口取平均再判断，单帧慢不再触发降速。恢复改为连续 3 个快
    窗口。降速日志改打窗口平均耗时，并同步更新宿主机测试。
2026-11-06 feat(cam): 自动更新传感器基准帧率
    未限速时每 5 秒用实际发布帧率滚动更新 base；限速时每 30 秒恢复默认
    时序重测，跟踪光照变化，避免 CLKRC/VTS 换算偏差。基准改用帧间隔中
    位数，抗启动抖动。重测期间发送仍按原目标限速，画面不会加速，同时清
    掉 cam_rate 的窗口样本避免误判；新增窗口重置接口和宿主机用例。
2026-11-06 feat(cam): 帧率上限夹到实测基准
    控制器实际上限取 min(用户配置, base)，避免目标被抬到传感器达不到
    的帧率；base 变化时同步更新上限。sensor fps 日志改打实际生效值，
    不再把请求值当成已生效。
2026-11-06 fix(cam): 区分用户配置上限与实际生效上限
    fps_cap 改成 min(用户配置, base) 后，前端仍用它回显输入框，用户改
    帧率会被下一帧遥测覆盖回 base。sys.cam 增加 fps_user_cap，输入框回
    显用户配置值；状态文本同时显示实际上限和配置值。
2026-11-07 feat(cam): 修正 OV5640 S3 PLL 并避开舵机 LEDC 冲突
    上游 PLL 在 S3/20MHz XCLK 下 VCO 1.8GHz、PCLK 11.25MHz，QVGA/VGA
    都只有 11fps。改用 hx-esp32-cam-fpv 验证过的 VGA 参数：VCO 606MHz、
    PCLK 20.22MHz，约 30fps。舵机 LEDC 从 TIMER_0/CH0 挪到 TIMER_1/CH2-3，
    避免把相机 XCLK 重配成 50Hz。base 观测加 1fps 迟滞，避免 11/12 抖动。
2026-11-07 fix(cam): 暂时关闭 OV5640 PLL 实验
    只改 PLL 后 VGA 到 15fps，但出现 NO-EOI、画面中断。hx 的方案还包含
    HTS/VTS、anti-banding 和 DRAM 帧缓冲的配套改动，完整移植前先关闭
    实验开关，恢复 11fps 可用画面。LEDC 冲突修复和 base 迟滞保留。
2026-11-07 feat(cam): OV5640 修正 PLL 与 anti-banding，PCLK 分频避开总线过载
    上游 PLL（180/4/2）把 VCO 推到 1.8GHz 超规格，VGA/SVGA/QVGA 都只剩
    11fps。换用 hx-esp32-cam-fpv 的 91/1/3 参数（VCO 606MHz），并按实测
    校准时钟模型（VCO/sys_div/5，hx 公式偏大一倍：上游 22.2→实测 11、
    新参数 29.9→实测 15，两个数据点都验证）。
    - anti-banding（0x3a02-0x3a15）按真实 SYSCLK/HTS/VTS 重算，VTS 改变
    时同步刷新，失败记 dirty 下次重试
    - PCLK 分频 3→6：帧率由 SYSCLK/VTS 决定不受影响，总线从 20.22MHz
    压回 10.11MHz，避开 Core1 上 1KB 节点拷贝被 httpd/WiFi 抢占导致
    的丢字节花屏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
2026-11-07 feat(cam): 网络拥堵时自适应降低 JPEG 画质
    帧率压到下限仍发不完一帧时，每 5 秒把 quality 加 2（最多比用户值高
    12 档）换取更小的帧；网络恢复后每两个快窗口还 2 档。决策在纯 C 的
    cam_quality，bench_cam 负责把结果写进传感器：写失败退避到下一个
    5 秒评估窗口，连续 3 次失败关掉自适应并把用户值写回。
    - cam_rate 增加 last_avg_valid，区分窗口平均 0ms（有效快样本）和
    无样本，避免画质降下去后回不来
    - base 观测下降改为连续两个 5 秒窗口确认，防止单次抖动把基准永久
    拉低形成递减
    - telemetry 增加 quality_eff（驱动确认写入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
2026-11-07 chore: 版本 1.0.2
2026-11-07 fix(wheel_speed): 防护相机串扰假脉冲，RPM 主位展示与图传独立 tab
    右前 GPIO14 被相机 PCLK/XCLK 夹住，开流时串扰假脉冲把真实轮周期
    切成两段，短段单独测频产生几百 RPM 尖峰。采集器新增间隔切分合并：
    短段挂起、与下一段之和落回 ±25% 窗口即合并；长段先上报的显示台阶
    由回滚修正抹掉（恢复上报前 math 快照、用合并周期重放）。窗口边界
    用严格不等式，真加速压边不误判。可疑间隔计数经 telemetry 上报前端
    用于诊断。新增 13 个宿主机测试用例。
    前端：轮速卡片 RPM 提到主位、RPS 退居次要行；相机预览从监测 tab
    独立为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
2026-11-07 feat(strategy): 打滑上锁前加 3 秒持续确认期
    IDLE 下出现打滑不再立即锁定，先内部计时：连续满足打滑条件满
    slip_confirm_ms（默认 3000）才进 LOCKED，期间任何一拍速差回落或
    轮子停下都清零重来，确认期间舵机保持解锁档。避免过坎/采样毛刺
    造成的瞬态速差机械锁一次。0 = 立即锁（旧行为）。
    配置走 cfg_params：blob 升 v6（旧数据解包补默认值），设置页新增
    确认期输入框，遥测与启动日志回显。PROBE 阶段再打滑仍立即锁回不变。
    宿主机测试同步新语义并新增确认期用例。
2026-11-08 fix(wheel_speed): 修复相机开启时右前轮 RPM 周期性跳涨与启动尖峰
    - 间隔法正常路径补重复轮询去重：源每 50ms 重复返回同一间隔，放行会覆写
    math_snapshot/prev 回滚参照，长段回滚"比上上段短 10%"永不成立，假脉冲
    切出的长段台阶无法撤销（现象：开摄像头后 RPM 周期性跳涨、可疑计数同步
    +1）。重复值只保鲜 last_pulse_ms 并按 last_valid 推进 EMA，不碰参照
    - 无基准首样本不再直采：使能瞬间 ISR 锁存的可能是切分段短值，直采曾让
    读数一闪几百 RPM（3~5s 才收敛）。首样本挂起等第二个不同间隔静默提升
    基准，再按正常状态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
2026-11-08 chore: 忽略本地 .claude/agents/
2026-11-08 feat(log): 远程日志查看、落盘轮转与浏览器对时
    - 新增 bench_log：vprintf 钩子 + 256 行 RAM 环 + esp_timer 刷盘到
    LittleFS（storage 分区），按小时轮转；单文件 128KiB 封顶、总量 6MiB
    配额；挂载失败不自动格式化，降级为只留实时视图
    - 新增 log_core 纯逻辑组件（环形缓冲/文件名解析/轮转/配额删除），
    并补宿主机单元测试
    - 新增 /api/logs/{live,list,file} 流式端点；WS log_clock 浏览器对时；
    OTA 上传/回退前后刷盘与暂停/恢复联动
    - 前端新增日志 tab：实时尾流、历史文件浏览、关键词高亮、E/W/I/D
    过滤与下载；E 红、W 黄，I/D 保持原样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
2026-11-08 feat：优化claude的agent分工，实验成本降低效果
2026-11-08 fix(ota): 升级完成后自动刷新页面并可靠确认切换
    - 上传/回退响应返回真实目标分区，页面不再依赖升级前的 /api/ota/info 快照
    - 设备重启后 WS 重连即查询 /api/ota/info 收尾；任务结束后自动 reload，
    未切到目标分区时也亮明实际运行分区和版本再刷新
    - 轮询超时后先复查实际状态，查不到才提示无法确认
    - 文件选择处显示固件编译时间，同版本号的两块镜像也能区分
    - 版本号升到 1.1.2
2026-11-14 fix：修复自动模式下低轮速情况下，轮速归0后不恢复问题
